drewsum/UV_Blaster/(threads)

Thread 1 (2020-04-20):

LED Selection

drewsum, 2020-04-20:
This looks promising:
https://www.digikey.com/product-detail/en/bivar-inc/SM0603UV-395/492-1949-1-ND/5030564

If I create a square grid, maybe I could do like 25 LEDs per panel...

The idea would be that you could chain multiple panels together with only one master panel controlling a ton of slave panels

drewsum, 2020-04-20:
Consider this for a driver on each card: https://www.analog.com/media/en/technical-documentation/data-sheets/3956f.pdf

Thread 2 (2020-04-20):

LED Driver

drewsum, 2020-04-20:
Consider this from TI, this looks pretty sweet

http://www.ti.com/lit/ds/symlink/lp8556.pdf

drewsum, 2020-04-20:
Actually use this, it's more simple:

http://www.ti.com/lit/ds/symlink/lp8545.pdf
