drewsum/UV_Blaster/hdw/UV_Blaster/UV_Blaster.pdf

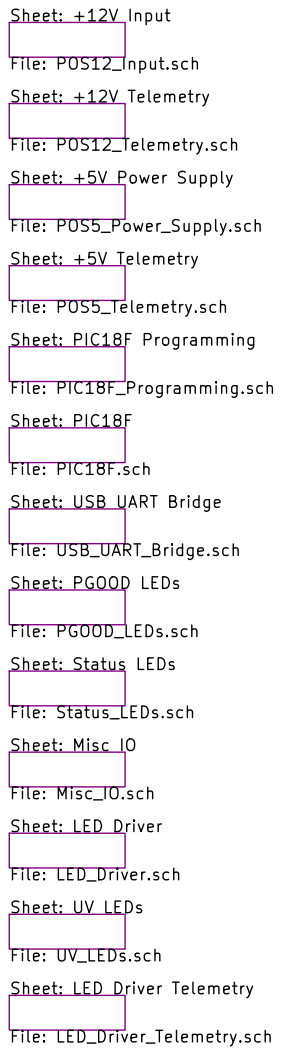
[picture p1: page 1]

File: PIC18F.sch Sheet: USB UART Bridge

File: USB_UART_Bridge.sch Sheet: PGOOD LEDs File: PGOOD_LEDs.sch Sheet: Status LEDs File: Status_LEDs.sch Sheet: Misc IO

File: Misc_IO.sch Sheet: LED Driver File: LED_Driver.sch Sheet: UV LEDs File: UV_LEDs.sch Sheet: LED Driver Telemetry

File: UV_Blaster.sch Sheet: / Drew Maatman

Id: 1/14 Title: UV Blaster

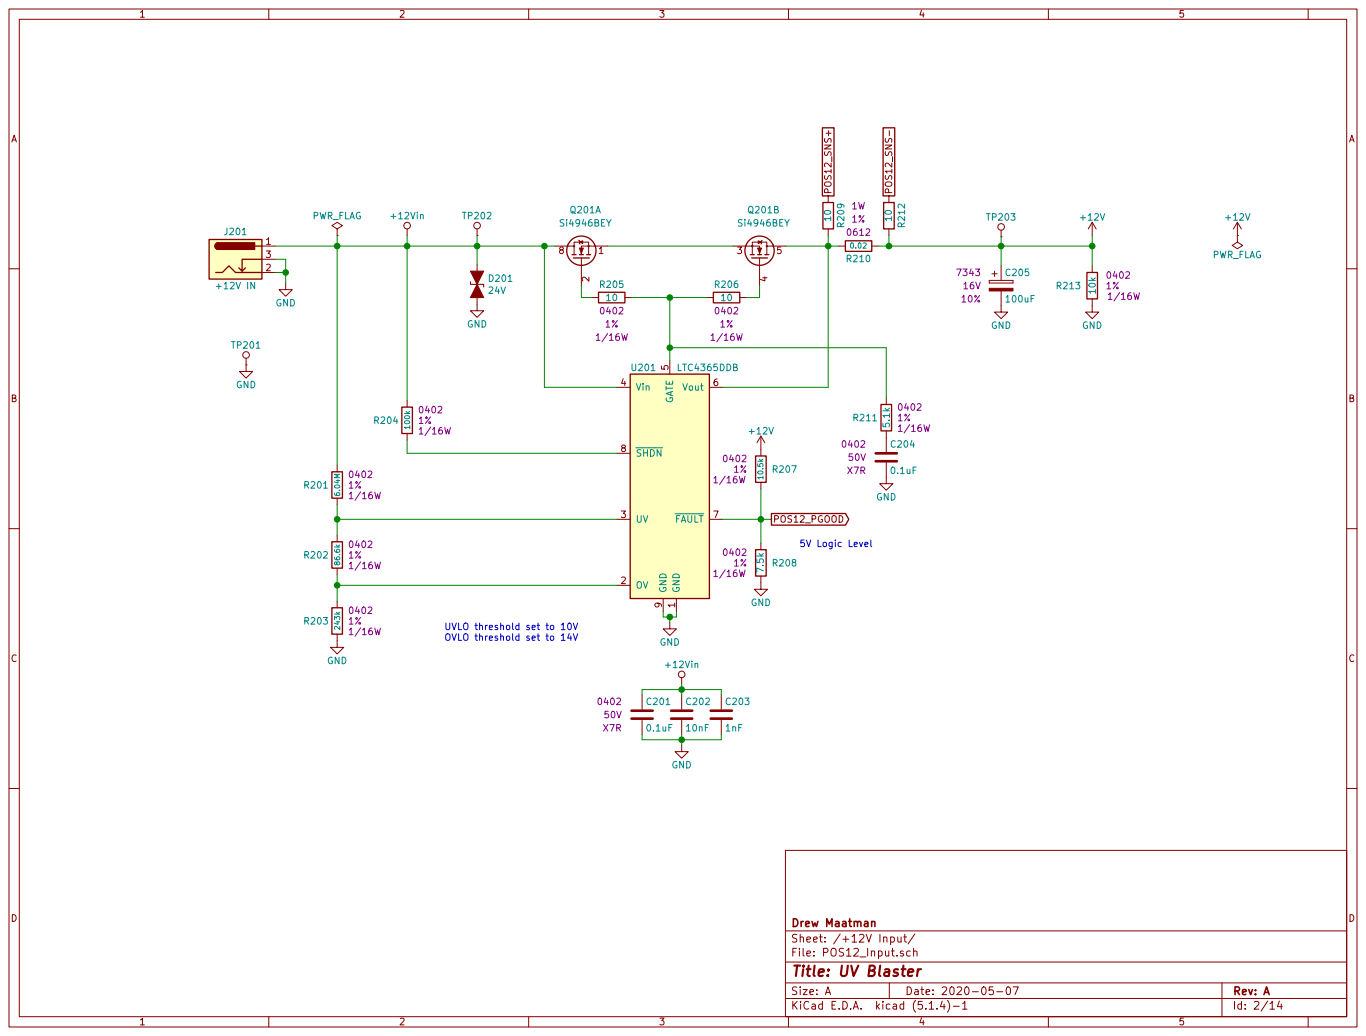
[picture p2: page 2]

5 Vout 6 FAULT 7 SHDN 8 GND

1 OV 2 UV 3 Vin 4 GATE

Sheet: /+12V Input/ Drew Maatman GND GND

File: POS12_Input.sch
Id: 2/14 Title: UV Blaster

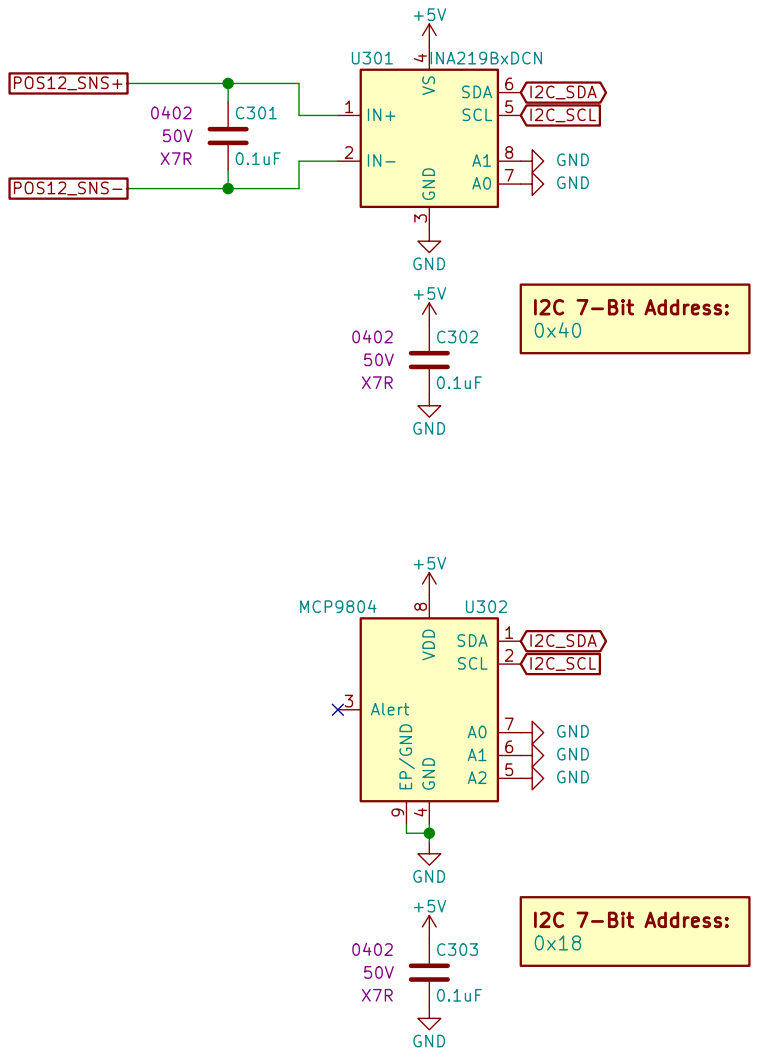
[picture p3: page 3]

Sheet: /+12V Telemetry/ Drew Maatman GND

File: POS12_Telemetry.sch
Id: 3/14 Title: UV Blaster

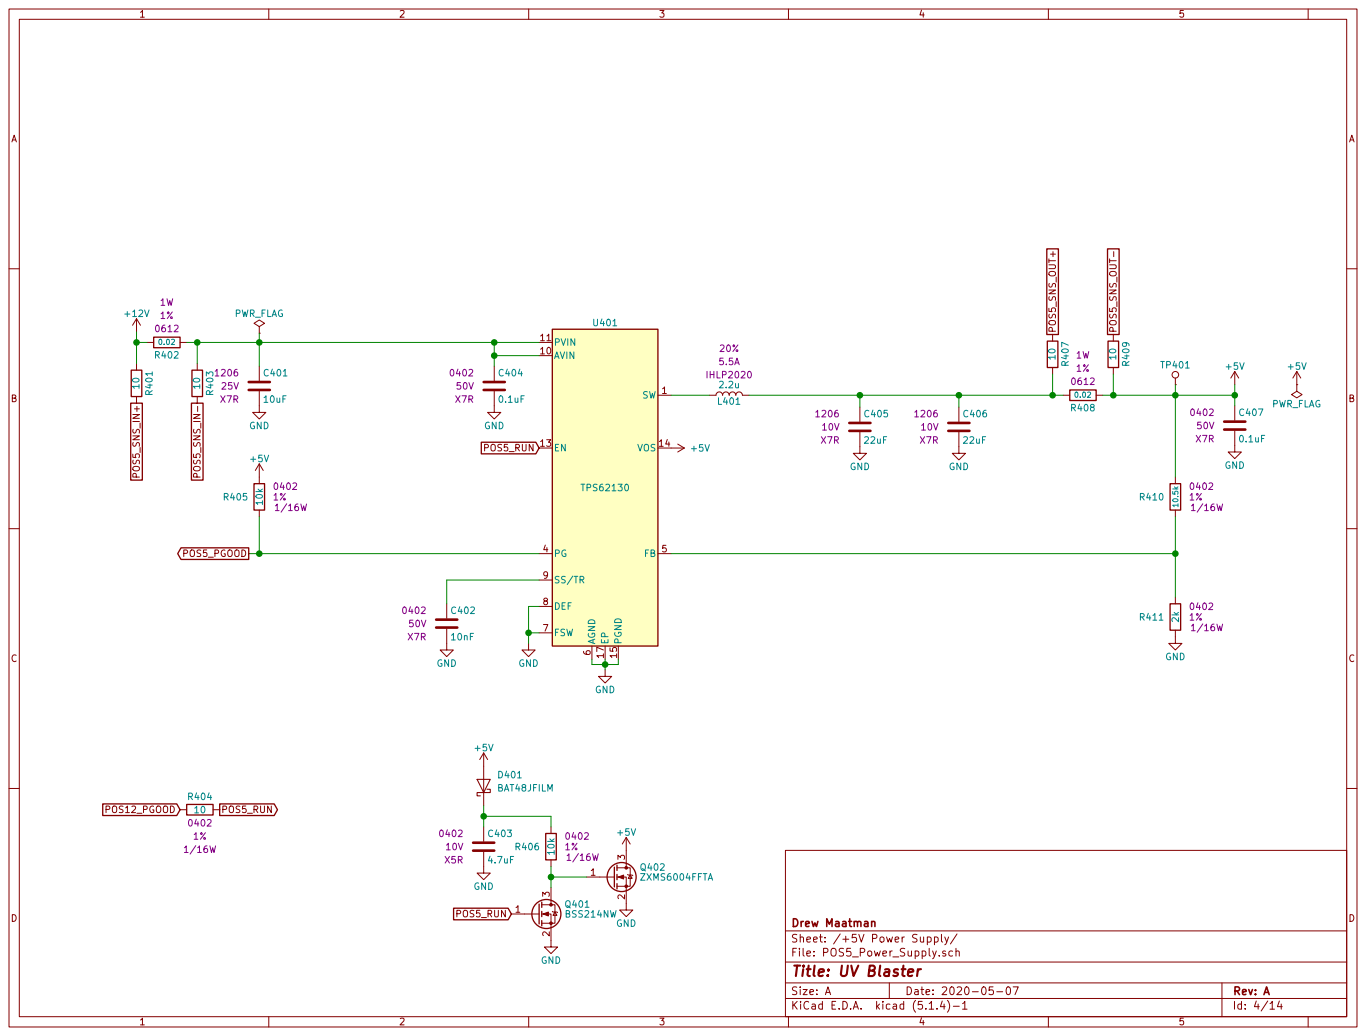
[picture p4: page 4]

6 FSW 7 DEF 8 SS/TR 9 U401 TPS62130 GND

File: POS5_Power_Supply.sch
Id: 4/14 Title: UV Blaster

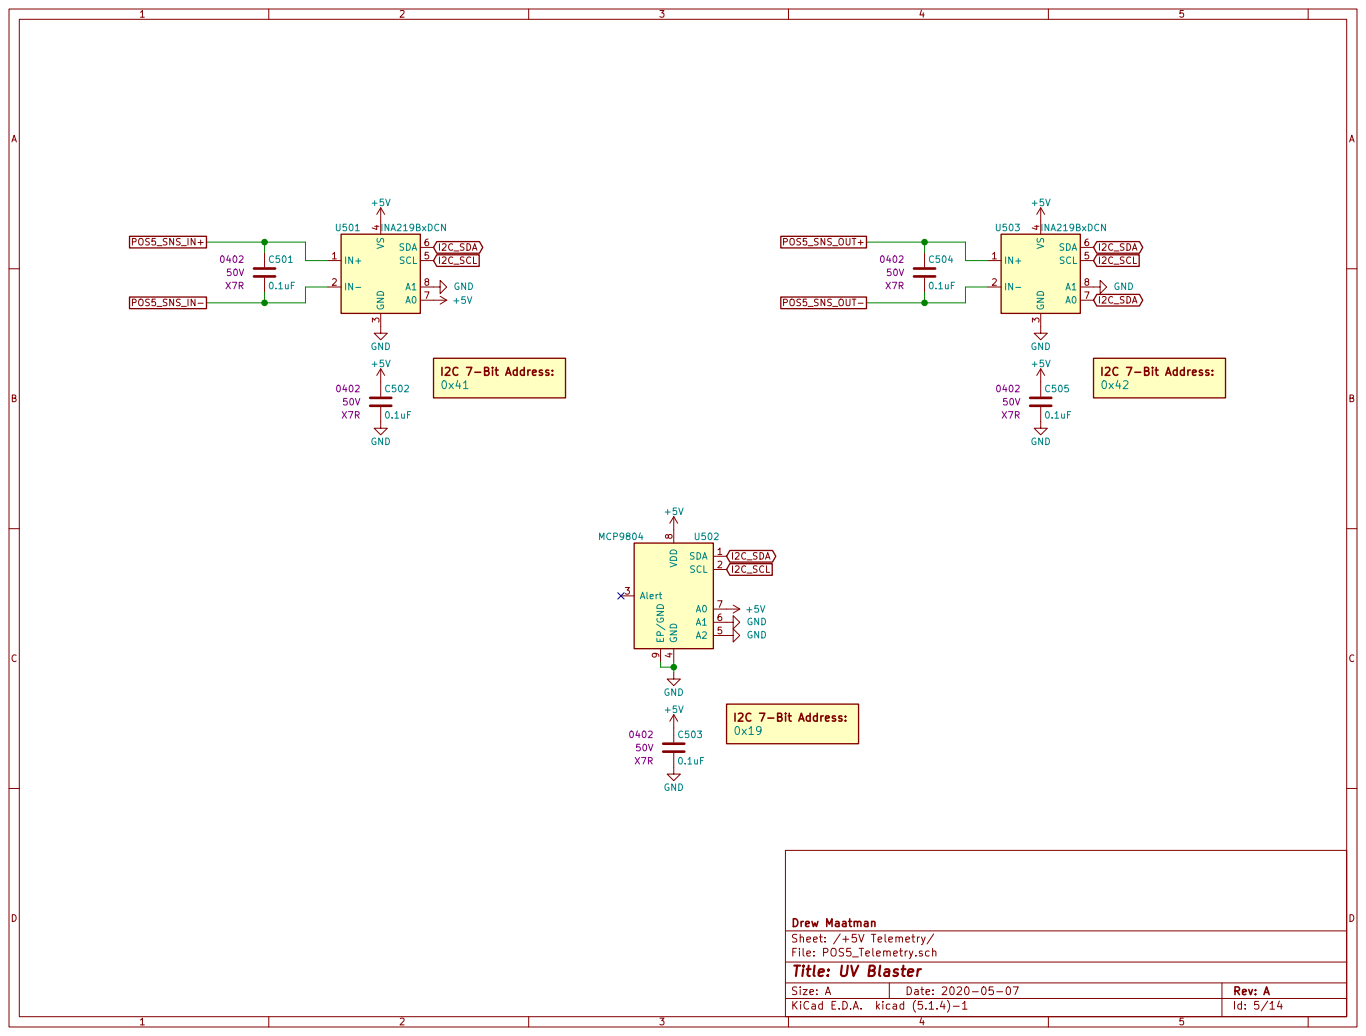
[picture p5: page 5]

Sheet: /+5V Telemetry/ Drew Maatman

File: POS5_Telemetry.sch
Id: 5/14 Title: UV Blaster

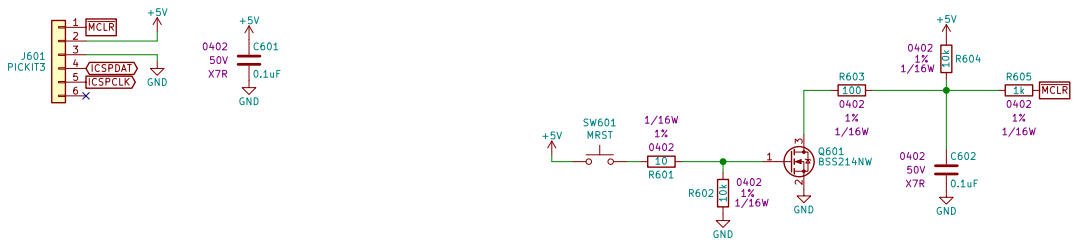
[picture p6: page 6]

Sheet: /PIC18F Programming/ Drew Maatman

File: PIC18F_Programming.sch
Id: 6/14 Title: UV Blaster

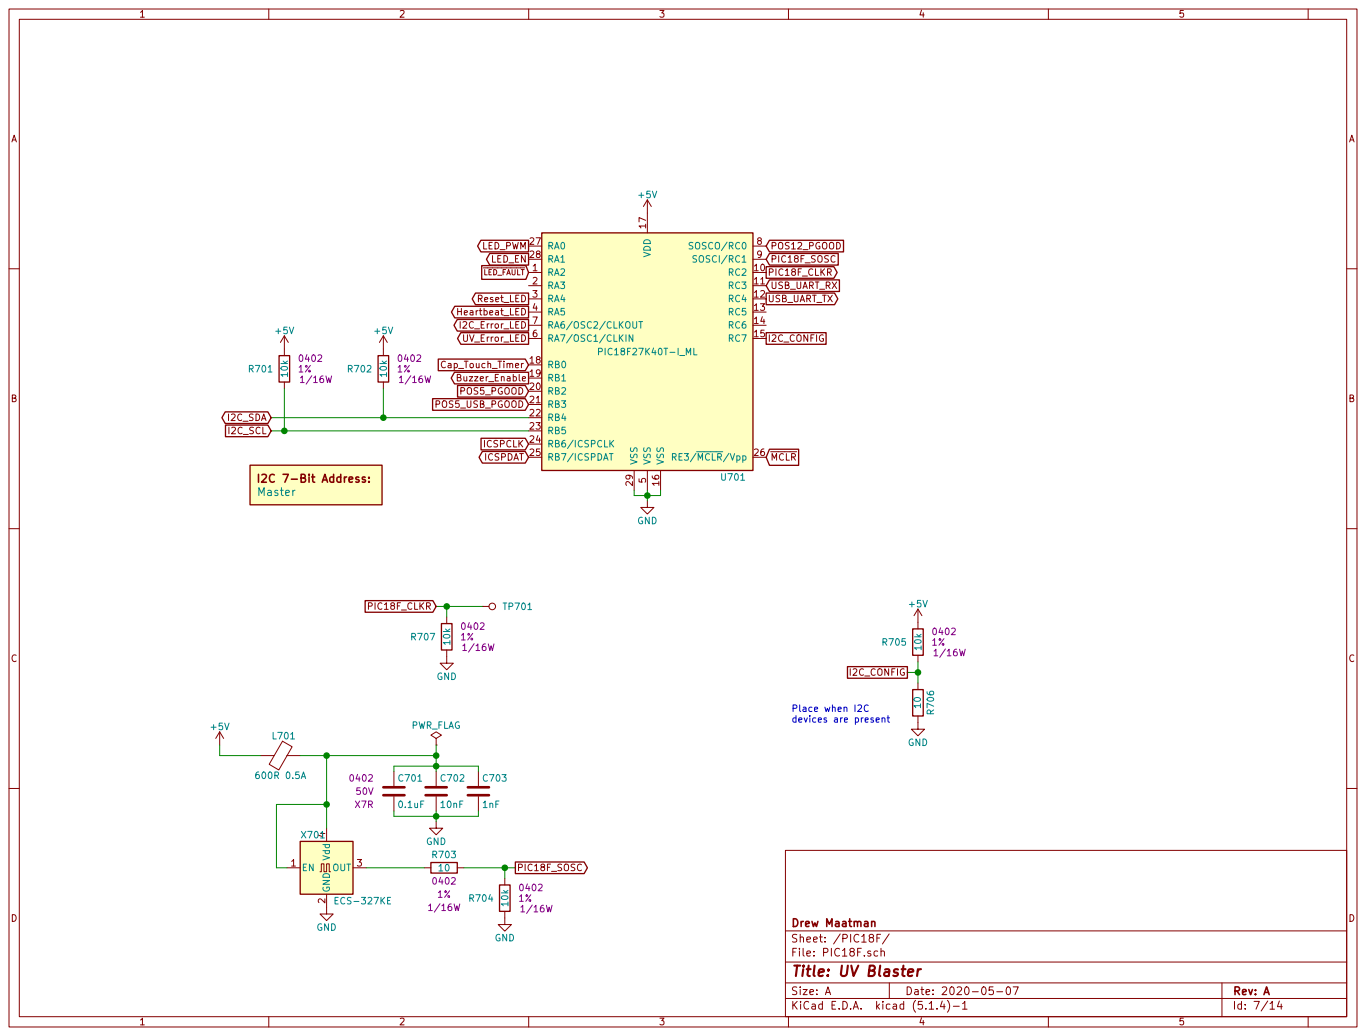
[picture p7: page 7]

2 OUT 3 Vdd X701 4 ECS-327KE GND

Id: 7/14 Title: UV Blaster File: PIC18F.sch Sheet: /PIC18F/ Drew Maatman

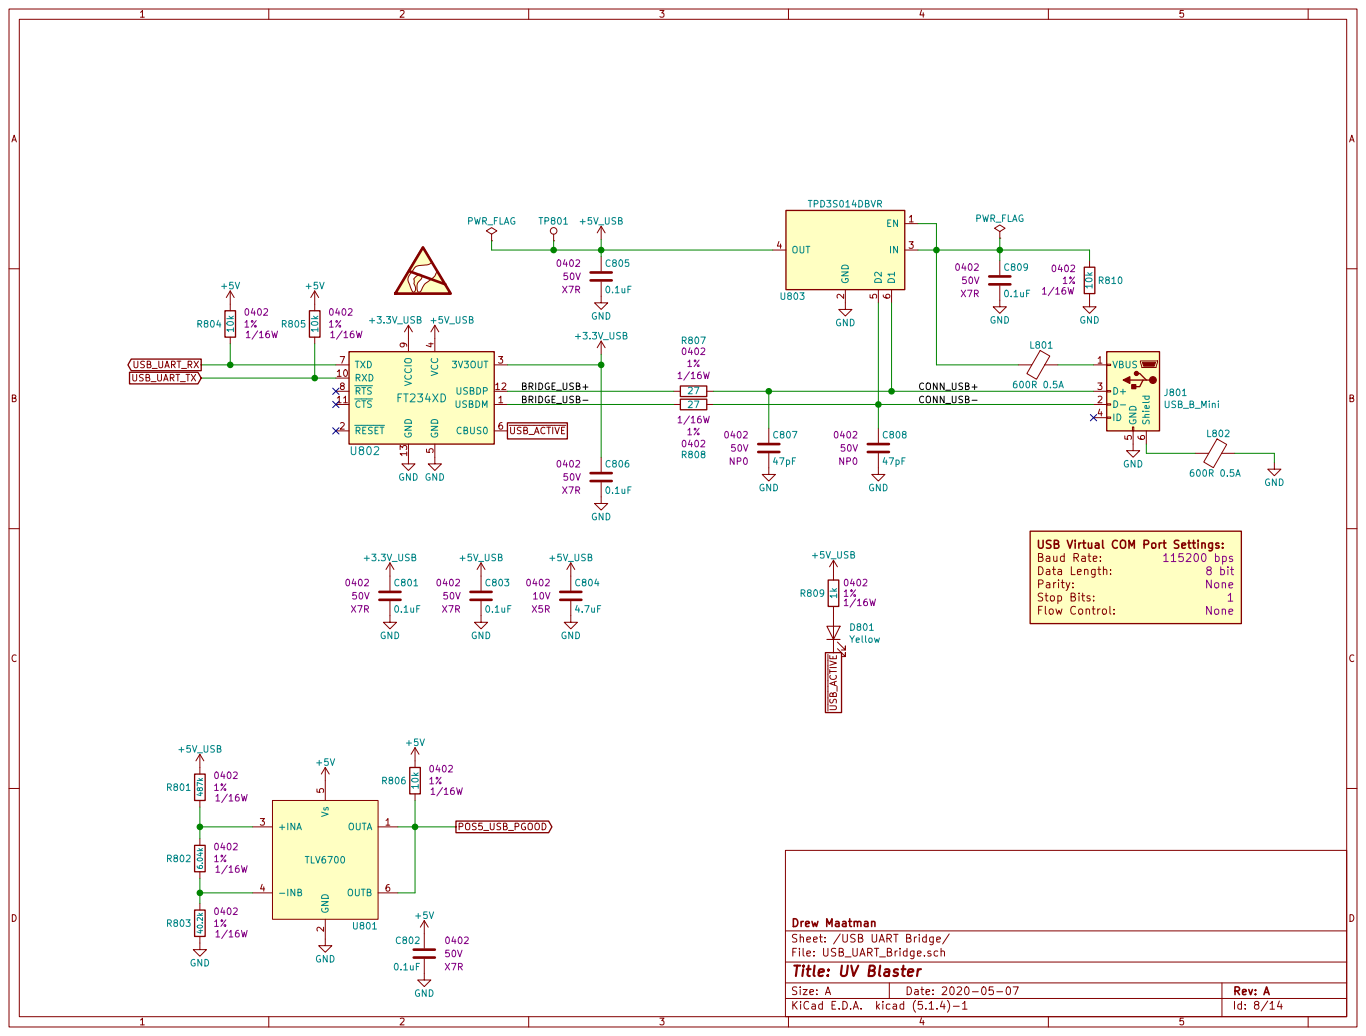
[picture p8: page 8]

USB Virtual COM Port Settings:
Baud Rate: Data Length:

File: USB_UART_Bridge.sch
Id: 8/14 Title: UV Blaster

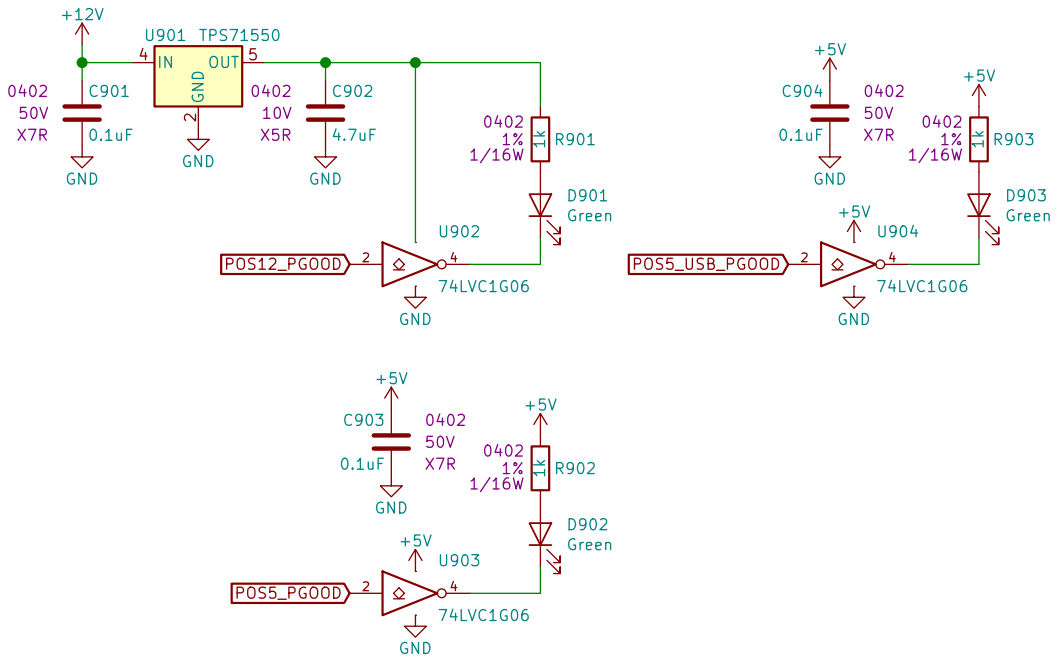
[picture p9: page 9]

File: PGOOD_LEDs.sch Sheet: /PGOOD LEDs/ Drew Maatman

Id: 9/14 Title: UV Blaster

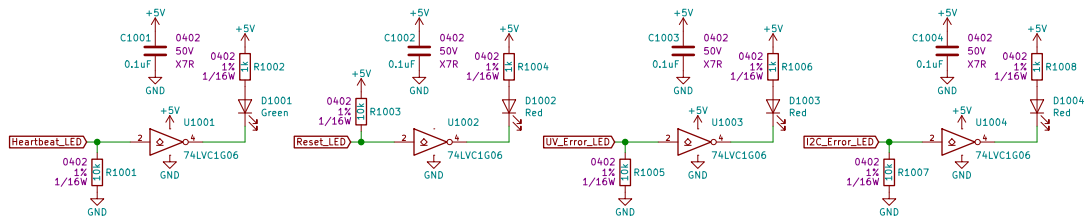
[picture p10: page 10]

File: Status_LEDs.sch Sheet: /Status LEDs/ Drew Maatman

Id: 10/14 Title: UV Blaster

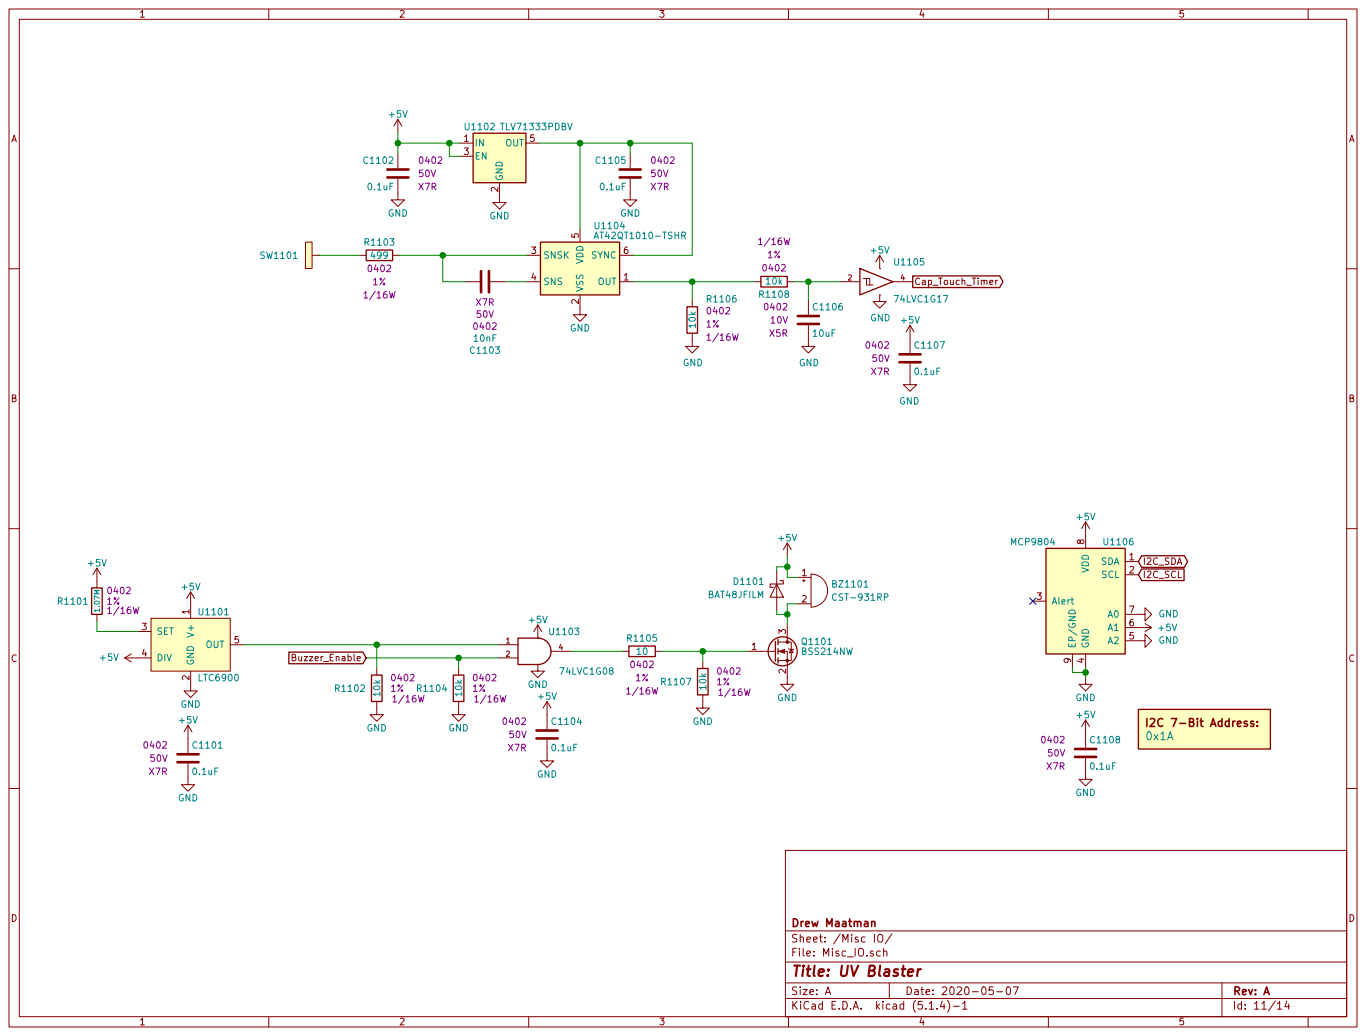
[picture p11: page 11]

1 GND
File: Misc_IO.sch Sheet: /Misc IO/ Drew Maatman V+

Id: 11/14 Title: UV Blaster

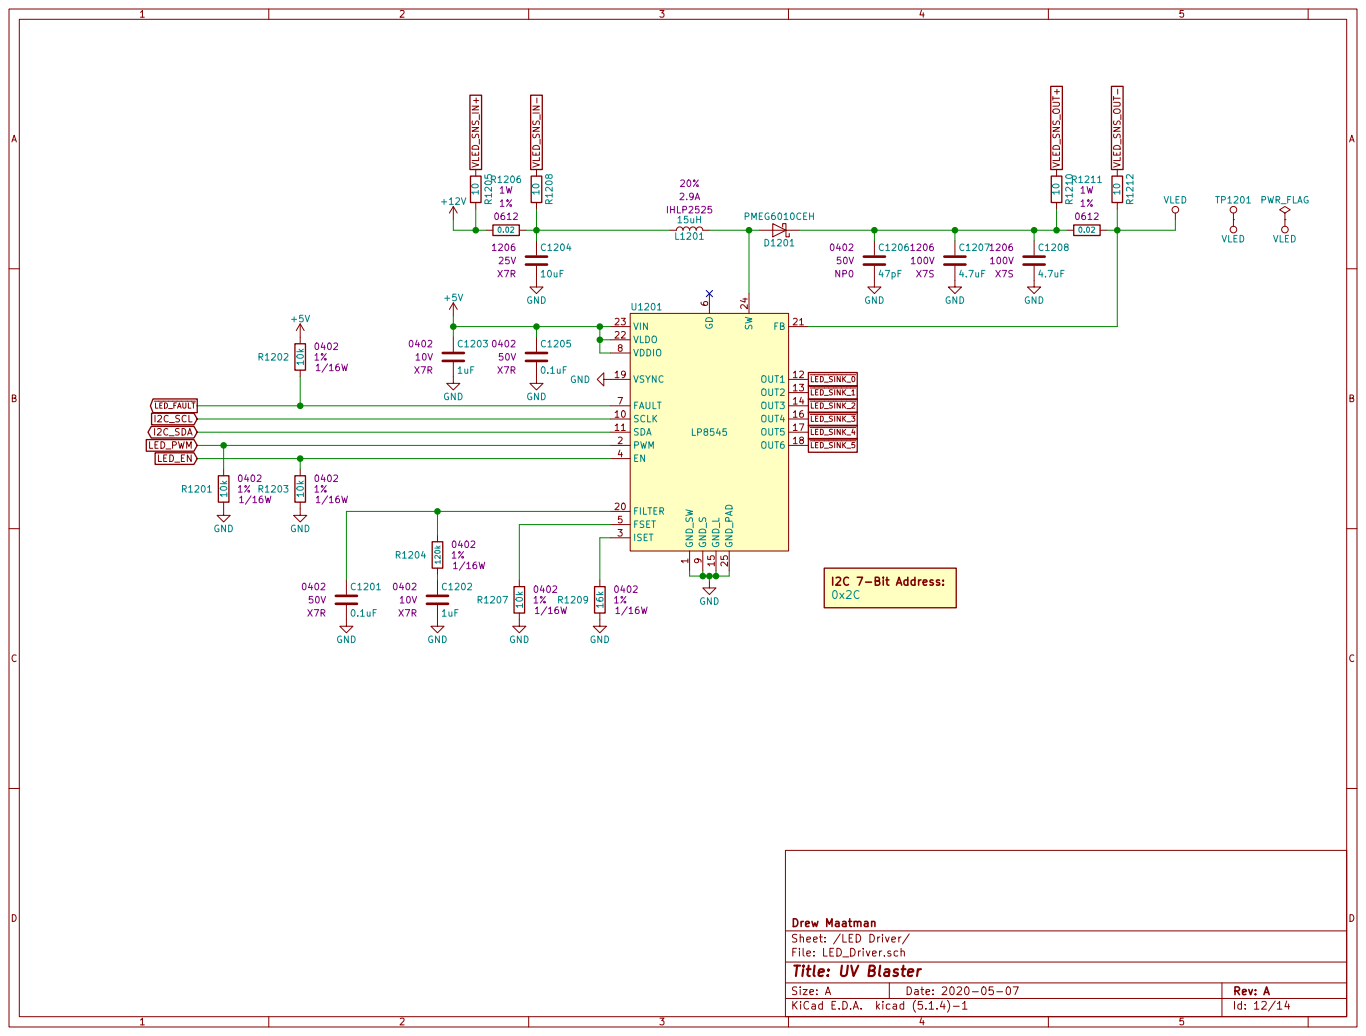
[picture p12: page 12]

1 SCLK 10 SDA 11 OUT1 12 OUT2 13 OUT3 14 GND_L 15 OUT4 16 OUT5 17 OUT6 18 VSYNC 19 PWM 2 FILTER 20 FB 21 VLDO 22 VIN 23 SW 24 GND_PAD 25

File: LED_Driver.sch Sheet: /LED Driver/ Drew Maatman

Id: 12/14 Title: UV Blaster

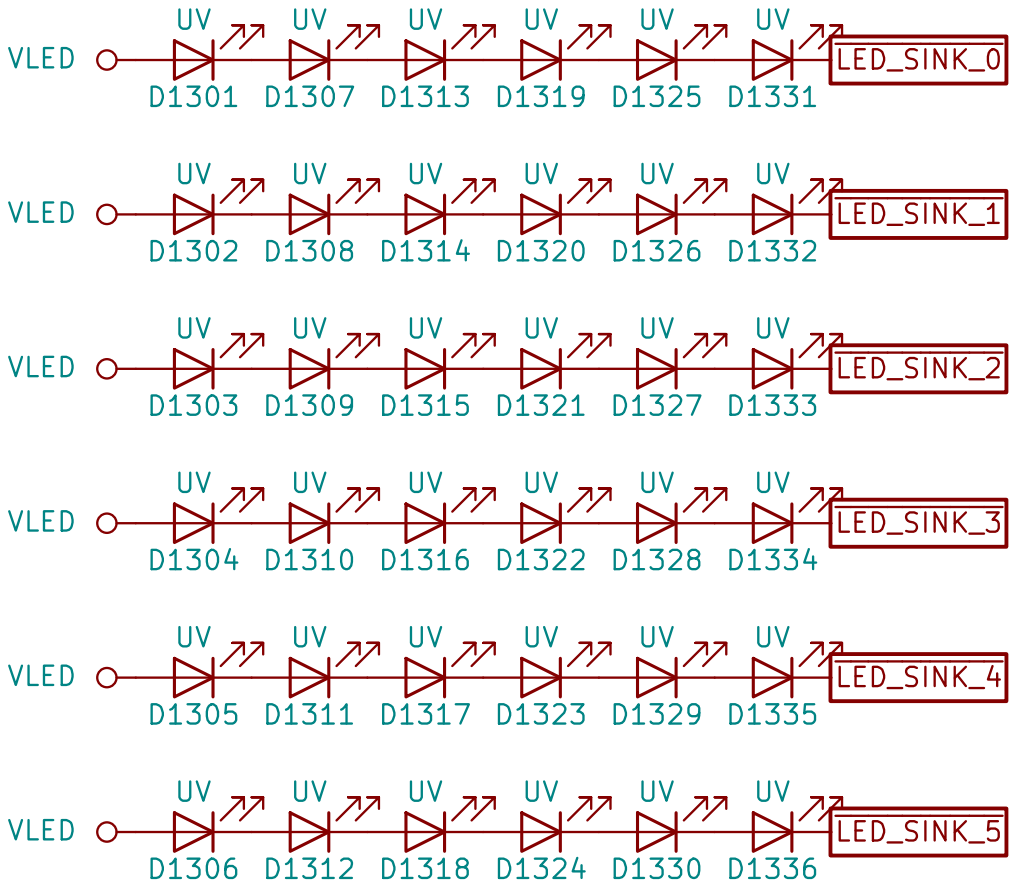
[picture p13: page 13]

File: UV_LEDs.sch Sheet: /UV LEDs/ Drew Maatman D1317 UV D1304 UV

Id: 13/14 Title: UV Blaster

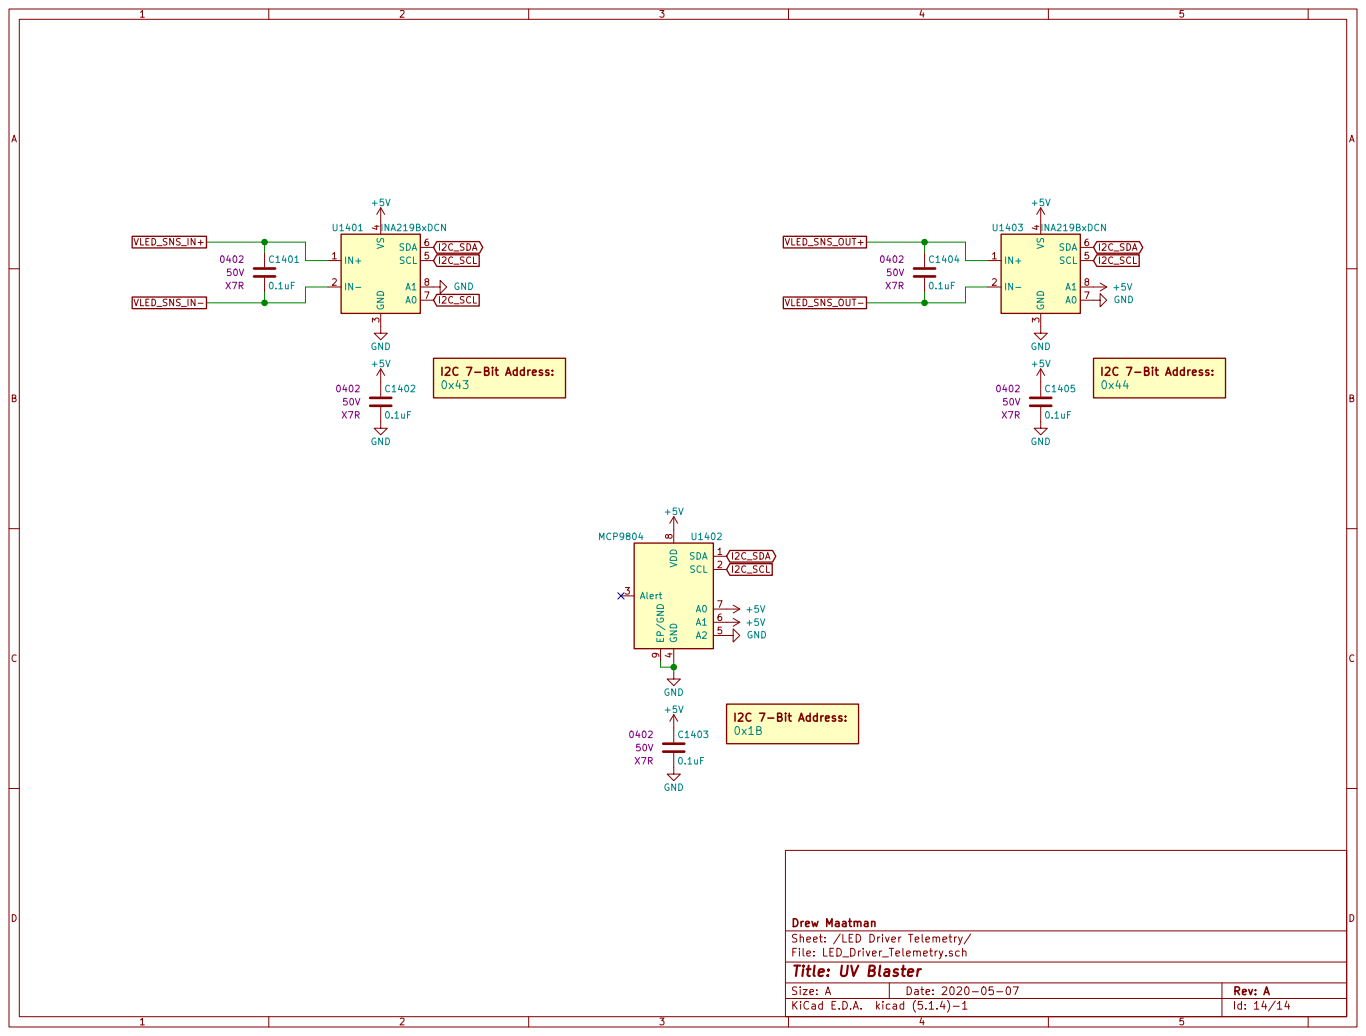
[picture p14: page 14]

Sheet: /LED Driver Telemetry/ Drew Maatman

File: LED_Driver_Telemetry.sch
Id: 14/14 Title: UV Blaster
