drewsum/UV_Blaster/hdw/UV_Blaster/UV_Blaster.kicad_pcb

## KiCad design hdw/UV_Blaster/UV_Blaster.kicad_pcb (2020-05-08)

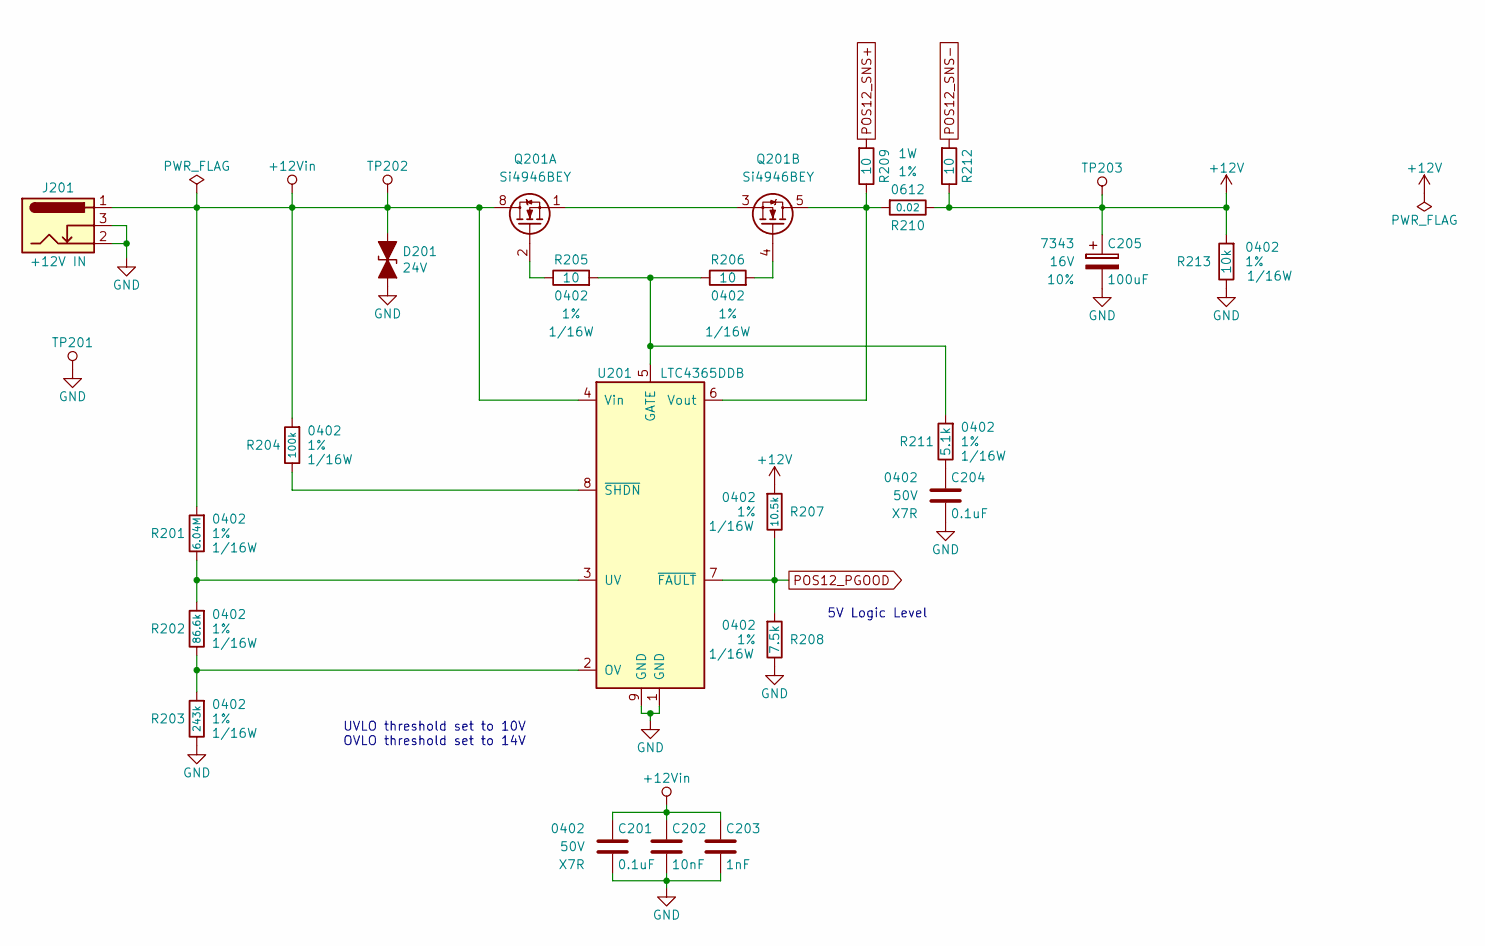
[picture p15: schematic POS12_Input.sch, UV Blaster]

Parts:
C201, C204: 0.1uF; C_0402; Voltage 50V; Digi-Key PN 490-10701-1-ND
C202: 10nF; C_0402; Voltage 50V; Digi-Key PN 490-13295-1-ND
C203: 1nF; C_0402; Voltage 50V; Digi-Key PN 399-1032-1-ND
C205: 100uF; CP_Tantalum_Case-X_EIA-7343-43_Reflow; Voltage 16V; Tolerance 10%; Digi-Key PN 718-1102-1-ND
D201: 24V; D_SMA; Digi-Key PN SMAJ24CALFCT-ND
J201: +12V IN; BARREL_JACK
Q201: Si4946BEY; SOIC-8_3.9x4.9mm_P1.27mm; Digi-Key PN SI4946BEY-T1-E3CT-ND
R201: 6.04M; R_0402; Tolerance 1%; Digi-Key PN 541-CRCW04026M04FKEDCT-ND
R202: 86.6k; R_0402; Tolerance 1%; Digi-Key PN P86.6KLCT-ND
R203: 243k; R_0402; Tolerance 1%; Digi-Key PN YAG3070CT-ND
R204: 100k; R_0402; Tolerance 1%; Digi-Key PN 311-100KLRCT-ND
R205, R206, R209, R212: 10; R_0402; Tolerance 1%; Digi-Key PN 311-10.0LRCT-ND
R207: 10.5k; R_0402; Tolerance 1%; Digi-Key PN RMCF0402FT10K5CT-ND
R208: 7.5k; R_0402; Tolerance 1%; Digi-Key PN RMCF0402FT7K50CT-ND
R210: 0.02; R_0612; Tolerance 1%; Digi-Key PN P16010CT-ND
R211: 5.1k; R_0402; Tolerance 1%; Digi-Key PN P5.10KLCT-ND
R213: 10k; R_0402; Tolerance 1%; Digi-Key PN 541-3959-1-ND
TP201: TP; Pin_Header_Angled_1x01_Pitch2.54mm
TP202, TP203: TP; Test_Point
U201: LTC4365DDB; DFN-8-1EP_2x3mm_Pitch0.5mm; Digi-Key PN LTC4365IDDB#TRMPBFCT-ND

Connections:
+12V: C205.1, R207.1, R210.2, R212.2, R213.1, TP203.1; also elsewhere on the board
+12Vin: C201.1, C202.1, C203.1, D201.1 (A1), J201.1, Q201.7 (D1), Q201.8 (D1), R201.1, R204.1, TP202.1, U201.4 (Vin)
GND: C201.2, C202.2, C203.2, C204.2, C205.2, D201.2 (A2), J201.2, J201.3, R203.2, R208.2, R213.2, TP201.1, U201.1 (GND), U201.9 (GND); also elsewhere on the board
unnamed: C204.1, R211.2
unnamed: Q201.1 (S1), Q201.3 (S2)
unnamed: Q201.2 (G1), R205.2
unnamed: Q201.4 (G2), R206.1
unnamed: Q201.5 (D2), Q201.6 (D2), R209.2, R210.1, U201.6 (Vout)
unnamed: R201.2, R202.1, U201.3 (UV)
unnamed: R202.2, R203.1, U201.2 (OV)
unnamed: R204.2, U201.8 (~SHDN)
unnamed: R205.1, R206.2, R211.1, U201.5 (GATE)
POS12_PGOOD: R207.2, R208.1, U201.7 (~FAULT); also elsewhere on the board
POS12_SNS+: R209.1; also elsewhere on the board
POS12_SNS-: R212.1; also elsewhere on the board

Notes on the sheet:
UVLO threshold set to 10V OVLO threshold set to 14V
5V Logic Level

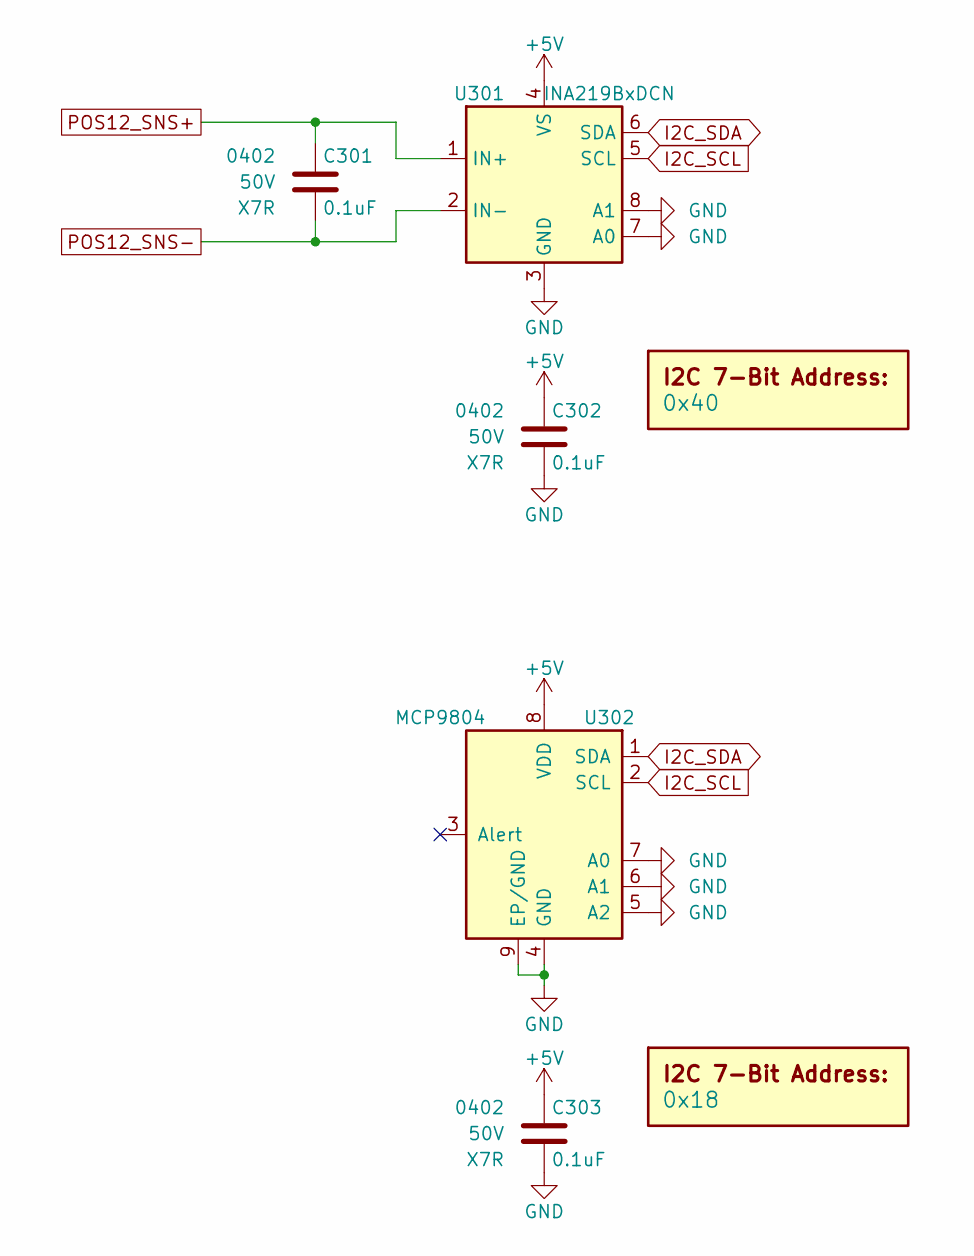
[picture p16: schematic POS12_Telemetry.sch, UV Blaster]

Parts:
C301, C302, C303: 0.1uF; C_0402; Voltage 50V; Digi-Key PN 490-10701-1-ND
DOC301: 0x40
DOC302: 0x18
U301: INA219BxDCN; SOT-23-8; Digi-Key PN 296-46420-1-ND
U302: MCP9804; DFN-8-1EP_3x2mm_P0.5mm_EP1.3x1.5mm; Digi-Key PN MCP9804T-E/MCCT-ND

Connections:
+5V: C302.1, C303.1, U301.4 (VS), U302.8 (VDD); also elsewhere on the board
GND: C302.2, C303.2, U301.3 (GND), U301.7 (A0), U301.8 (A1), U302.4 (GND), U302.5 (A2), U302.6 (A1), U302.7 (A0), U302.9 (EP/GND); also elsewhere on the board
I2C_SCL: U301.5 (SCL), U302.2 (SCL); also elsewhere on the board
I2C_SDA: U301.6 (SDA), U302.1 (SDA); also elsewhere on the board
POS12_SNS+: C301.1, U301.1 (IN+); also elsewhere on the board
POS12_SNS-: C301.2, U301.2 (IN-); also elsewhere on the board

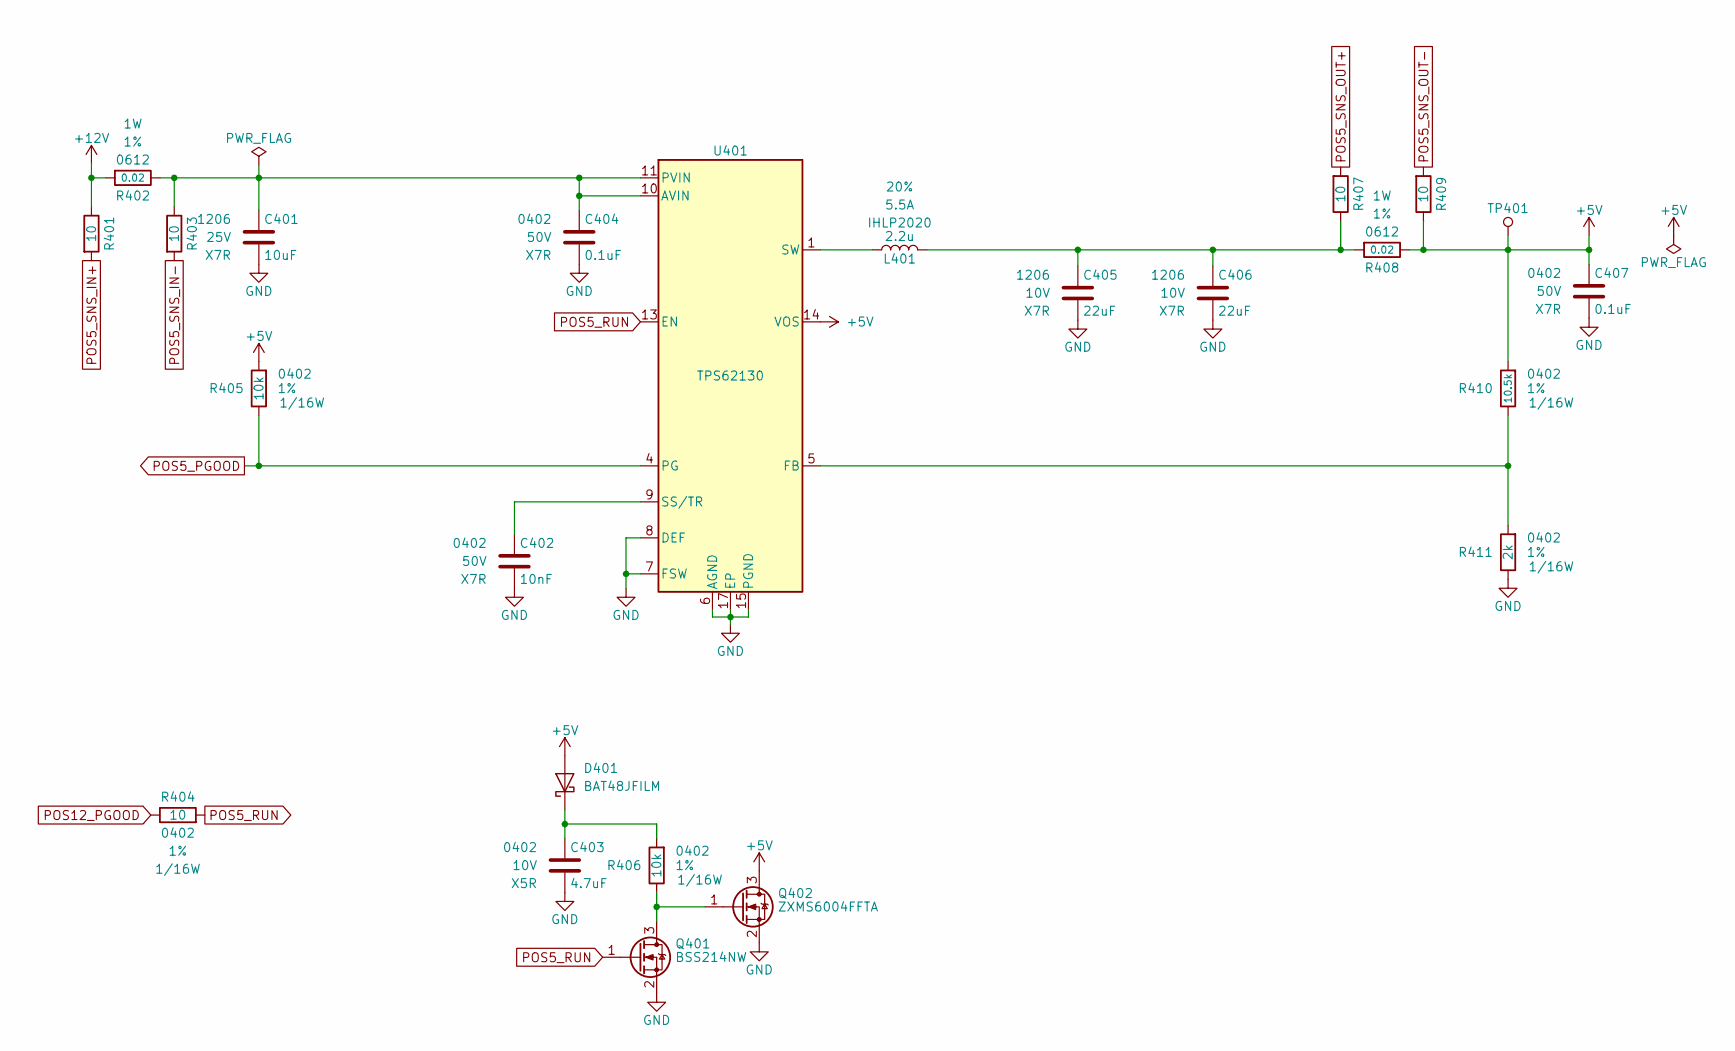
[picture p17: schematic POS5_Power_Supply.sch, UV Blaster]

Parts:
C401: 10uF; C_1206; Voltage 25V; Digi-Key PN 1276-7031-1-ND
C402: 10nF; C_0402; Voltage 50V; Digi-Key PN 490-13295-1-ND
C403: 4.7uF; C_0402; Voltage 10V; Digi-Key PN 490-14306-1-ND
C404, C407: 0.1uF; C_0402; Voltage 50V; Digi-Key PN 490-10701-1-ND
C405, C406: 22uF; C_1206; Voltage 10V; Digi-Key PN 1276-3148-1-ND
D401: BAT48JFILM; D_SOD-323; Digi-Key PN 497-5711-1-ND
L401: 2.2u; L_Vishay_IHLP-2020; Tolerance 20%; Digi-Key PN 541-1236-1-ND
Q401: BSS214NW; SOT-323_SC-70; Digi-Key PN BSS214NWH6327XTSA1CT-ND
Q402: ZXMS6004FFTA; SOT-23; Digi-Key PN ZXMS6004FFCT-ND
R401, R403, R404, R407, R409: 10; R_0402; Tolerance 1%; Digi-Key PN 311-10.0LRCT-ND
R402, R408: 0.02; R_0612; Tolerance 1%; Digi-Key PN P16010CT-ND
R405, R406: 10k; R_0402; Tolerance 1%; Digi-Key PN 541-3959-1-ND
R410: 10.5k; R_0402; Tolerance 1%; Digi-Key PN RMCF0402FT10K5CT-ND
R411: 2k; R_0402; Tolerance 1%; Digi-Key PN 311-2KLRCT-ND
TP401: TP; Test_Point
U401: TPS62130; QFN-16-1EP_3x3mm_Pitch0.5mm; Digi-Key PN 296-37878-1-ND

Connections:
+5V: C407.1, D401.2 (A), Q402.3 (D), R405.1, R408.2, R409.2, R410.1, TP401.1, U401.14 (VOS); also elsewhere on the board
+12V: R401.2, R402.1; also elsewhere on the board
GND: C401.2, C402.2, C403.2, C404.2, C405.2, C406.2, C407.2, Q401.2 (S), Q402.2 (S), R411.2, U401.6 (AGND), U401.7 (FSW), U401.8 (DEF), U401.15 (PGND), U401.16 (PGND), U401.17 (EP); also elsewhere on the board
unnamed: C401.1, C404.1, R402.2, R403.2, U401.10 (AVIN), U401.11 (PVIN), U401.12 (PVIN)
unnamed: C402.1, U401.9 (SS/TR)
unnamed: C403.1, D401.1 (K), R406.1
unnamed: C405.1, C406.1, L401.2, R407.2, R408.1
unnamed: L401.1, U401.1 (SW), U401.2 (SW), U401.3 (SW)
unnamed: Q401.3 (D), Q402.1 (G), R406.2
unnamed: R410.2, R411.1, U401.5 (FB)
POS5_PGOOD: R405.2, U401.4 (PG); also elsewhere on the board
POS5_RUN: Q401.1 (G), R404.1, U401.13 (EN)
POS5_SNS_IN+: R401.1; also elsewhere on the board
POS5_SNS_IN-: R403.1; also elsewhere on the board
POS5_SNS_OUT+: R407.1; also elsewhere on the board
POS5_SNS_OUT-: R409.1; also elsewhere on the board
POS12_PGOOD: R404.2; also elsewhere on the board

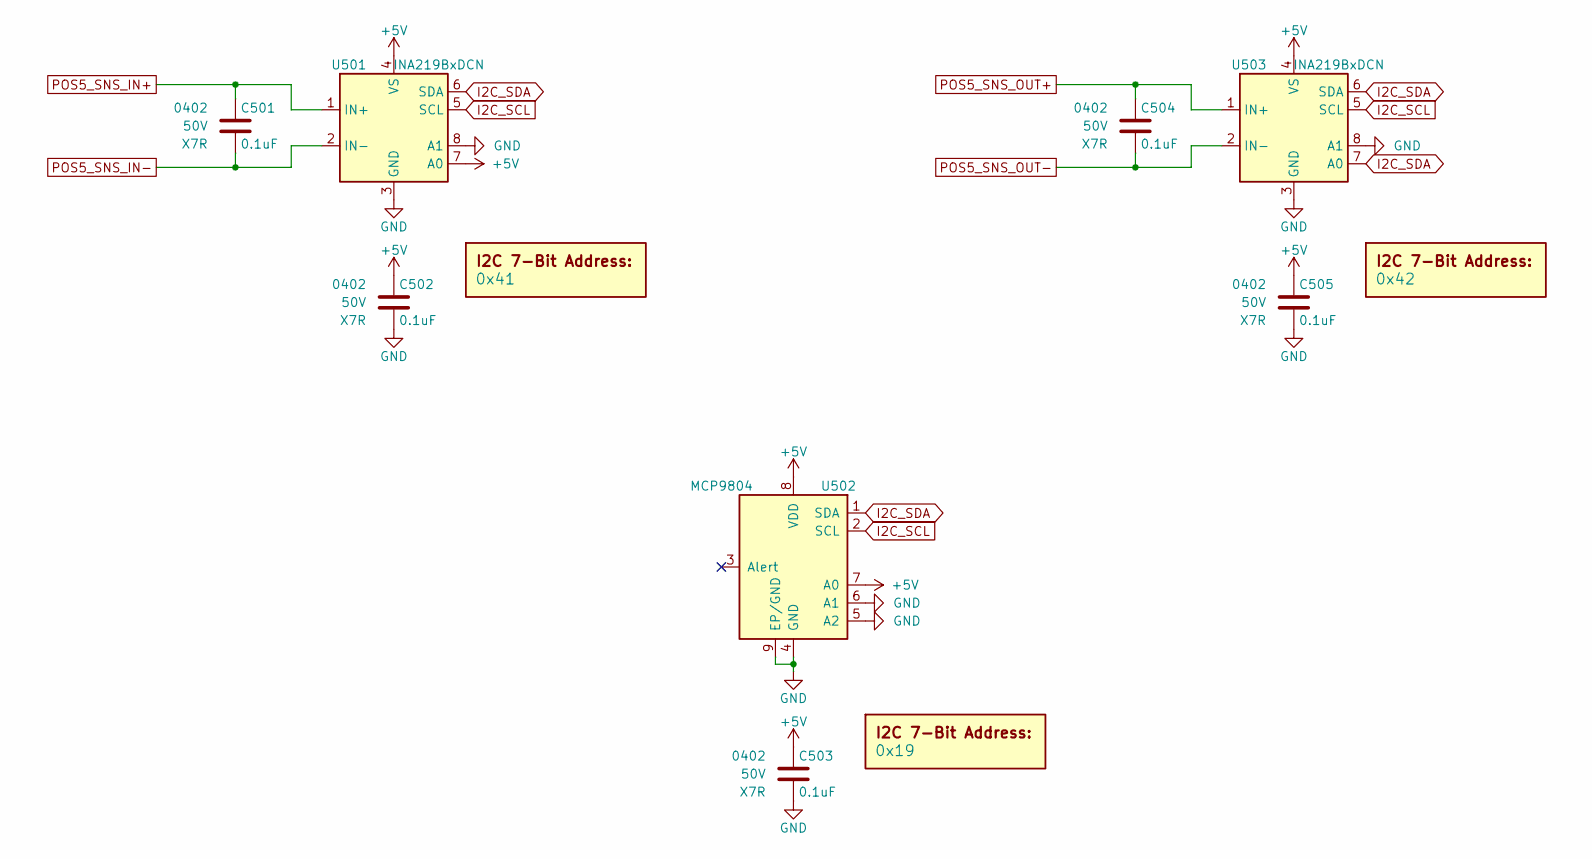
[picture p18: schematic POS5_Telemetry.sch, UV Blaster]

Parts:
C501, C502, C503, C504, C505: 0.1uF; C_0402; Voltage 50V; Digi-Key PN 490-10701-1-ND
DOC501: 0x41
DOC502: 0x19
DOC503: 0x42
U501, U503: INA219BxDCN; SOT-23-8; Digi-Key PN 296-46420-1-ND
U502: MCP9804; DFN-8-1EP_3x2mm_P0.5mm_EP1.3x1.5mm; Digi-Key PN MCP9804T-E/MCCT-ND

Connections:
+5V: C502.1, C503.1, C505.1, U501.4 (VS), U501.7 (A0), U502.7 (A0), U502.8 (VDD), U503.4 (VS); also elsewhere on the board
GND: C502.2, C503.2, C505.2, U501.3 (GND), U501.8 (A1), U502.4 (GND), U502.5 (A2), U502.6 (A1), U502.9 (EP/GND), U503.3 (GND), U503.8 (A1); also elsewhere on the board
I2C_SCL: U501.5 (SCL), U502.2 (SCL), U503.5 (SCL); also elsewhere on the board
I2C_SDA: U501.6 (SDA), U502.1 (SDA), U503.6 (SDA), U503.7 (A0); also elsewhere on the board
POS5_SNS_IN+: C501.1, U501.1 (IN+); also elsewhere on the board
POS5_SNS_IN-: C501.2, U501.2 (IN-); also elsewhere on the board
POS5_SNS_OUT+: C504.1, U503.1 (IN+); also elsewhere on the board
POS5_SNS_OUT-: C504.2, U503.2 (IN-); also elsewhere on the board

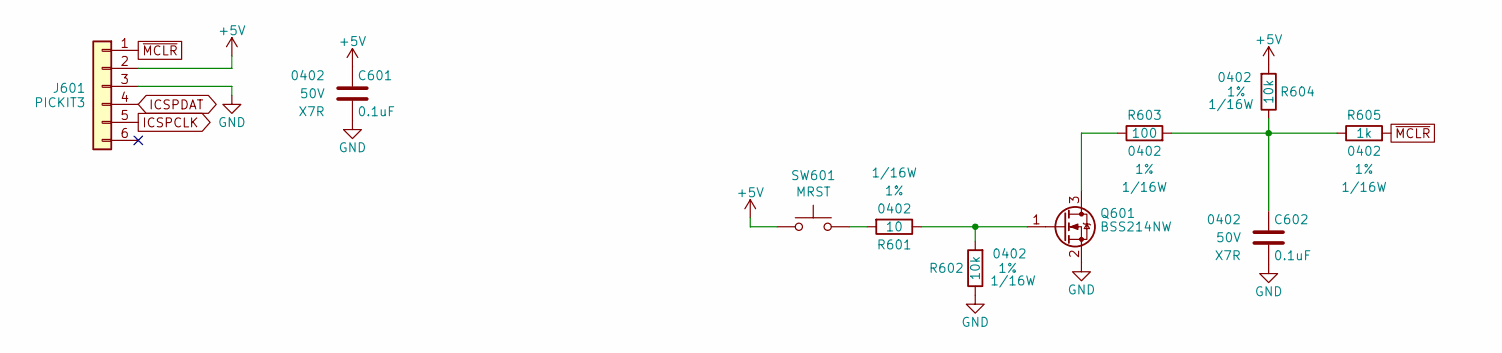
[picture p19: schematic PIC18F_Programming.sch, UV Blaster]

Parts:
C601, C602: 0.1uF; C_0402; Voltage 50V; Digi-Key PN 490-10701-1-ND
J601: PICKIT3; PICKIT3_Header
Q601: BSS214NW; SOT-323_SC-70; Digi-Key PN BSS214NWH6327XTSA1CT-ND
R601: 10; R_0402; Tolerance 1%; Digi-Key PN 311-10.0LRCT-ND
R602, R604: 10k; R_0402; Tolerance 1%; Digi-Key PN 541-3959-1-ND
R603: 100; R_0402; Tolerance 1%; Digi-Key PN 311-100LRCT-ND
R605: 1k; R_0402; Tolerance 1%; Digi-Key PN P1.00KLCT-ND
SW601: MRST; SW_PUSH_6mm

Connections:
+5V: C601.1, J601.2, R604.1, SW601.1; also elsewhere on the board
GND: C601.2, C602.2, J601.3, Q601.2 (S), R602.2; also elsewhere on the board
ICSPCLK: J601.5; also elsewhere on the board
ICSPDAT: J601.4; also elsewhere on the board
unnamed: C602.1, R603.1, R604.2, R605.2
unnamed: Q601.1 (G), R601.2, R602.1
unnamed: Q601.3 (D), R603.2
unnamed: R601.1, SW601.2
~MCLR: J601.1, R605.1; also elsewhere on the board

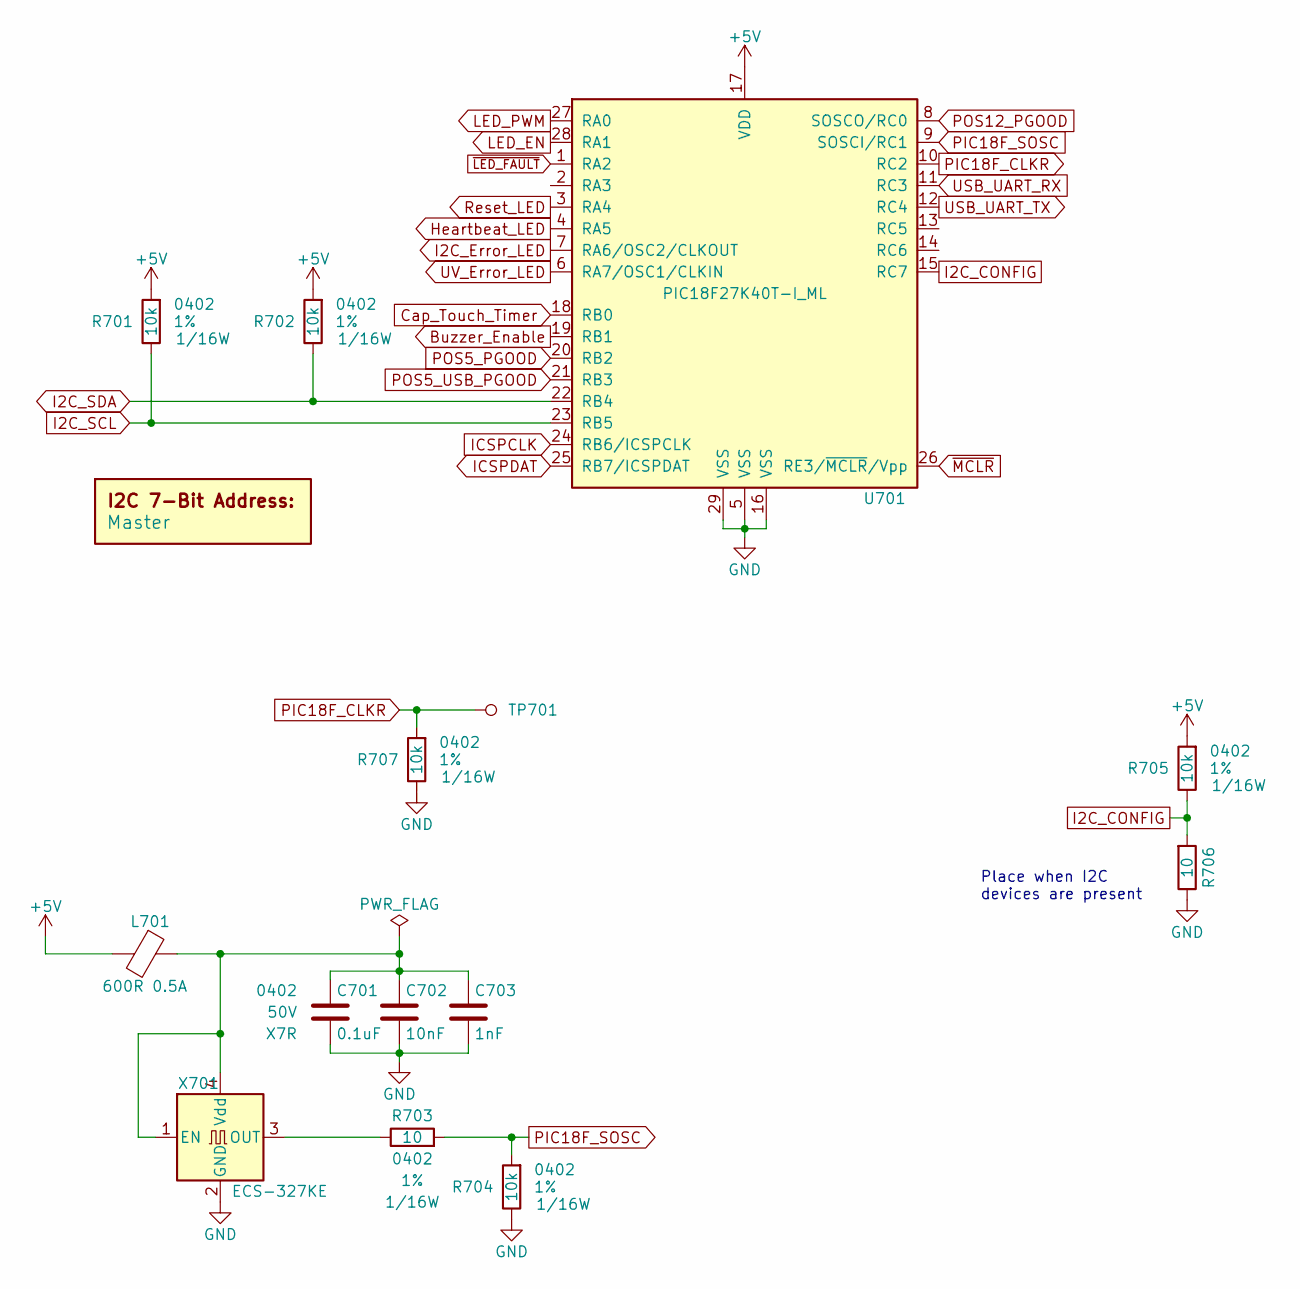
[picture p20: schematic PIC18F.sch, UV Blaster]

Parts:
C701: 0.1uF; C_0402; Voltage 50V; Digi-Key PN 490-10701-1-ND
C702: 10nF; C_0402; Voltage 50V; Digi-Key PN 490-13295-1-ND
C703: 1nF; C_0402; Voltage 50V; Digi-Key PN 399-1032-1-ND
DOC701: Master
L701: 600R 0.5A; L_0402; Digi-Key PN 490-16584-1-ND
R701, R702, R704, R705, R707: 10k; R_0402; Tolerance 1%; Digi-Key PN 541-3959-1-ND
R703, R706: 10; R_0402; Tolerance 1%; Digi-Key PN 311-10.0LRCT-ND
TP701: TP; Test_Point
U701: PIC18F27K40T-I_ML; QFN-28-1EP_6x6mm_Pitch0.65mm; Digi-Key PN PIC18F27K40T-I/MLCT-ND
X701: ECS-327KE; Digi-Key PN XC1751CT-ND

Connections:
+5V: L701.2, R701.1, R702.1, R705.1, U701.17 (VDD); also elsewhere on the board
Buzzer_Enable: U701.19 (RB1); also elsewhere on the board
Cap_Touch_Timer: U701.18 (RB0); also elsewhere on the board
GND: C701.2, C702.2, C703.2, R704.2, R706.2, R707.2, U701.5 (VSS), U701.16 (VSS), U701.29 (VSS), X701.2 (GND); also elsewhere on the board
Heartbeat_LED: U701.4 (RA5); also elsewhere on the board
I2C_CONFIG: R705.2, R706.1, U701.15 (RC7)
I2C_Error_LED: U701.7 (RA6/OSC2/CLKOUT); also elsewhere on the board
I2C_SCL: R701.2, U701.23 (RB5); also elsewhere on the board
I2C_SDA: R702.2, U701.22 (RB4); also elsewhere on the board
ICSPCLK: U701.24 (RB6/ICSPCLK); also elsewhere on the board
ICSPDAT: U701.25 (RB7/ICSPDAT); also elsewhere on the board
LED_EN: U701.28 (RA1); also elsewhere on the board
LED_PWM: U701.27 (RA0); also elsewhere on the board
unnamed: C701.1, C702.1, C703.1, L701.1, X701.1 (EN), X701.4 (Vdd)
unnamed: R703.2, X701.3 (OUT)
PIC18F_CLKR: R707.1, TP701.1, U701.10 (RC2)
PIC18F_SOSC: R703.1, R704.1, U701.9 (SOSCI/RC1)
POS5_PGOOD: U701.20 (RB2); also elsewhere on the board
POS5_USB_PGOOD: U701.21 (RB3); also elsewhere on the board
POS12_PGOOD: U701.8 (SOSCO/RC0); also elsewhere on the board
Reset_LED: U701.3 (RA4); also elsewhere on the board
USB_UART_RX: U701.11 (RC3); also elsewhere on the board
USB_UART_TX: U701.12 (RC4); also elsewhere on the board
UV_Error_LED: U701.6 (RA7/OSC1/CLKIN); also elsewhere on the board
~LED_FAULT: U701.1 (RA2); also elsewhere on the board
~MCLR: U701.26 (RE3/~MCLR~/Vpp); also elsewhere on the board

Notes on the sheet:
Place when I2C devices are present

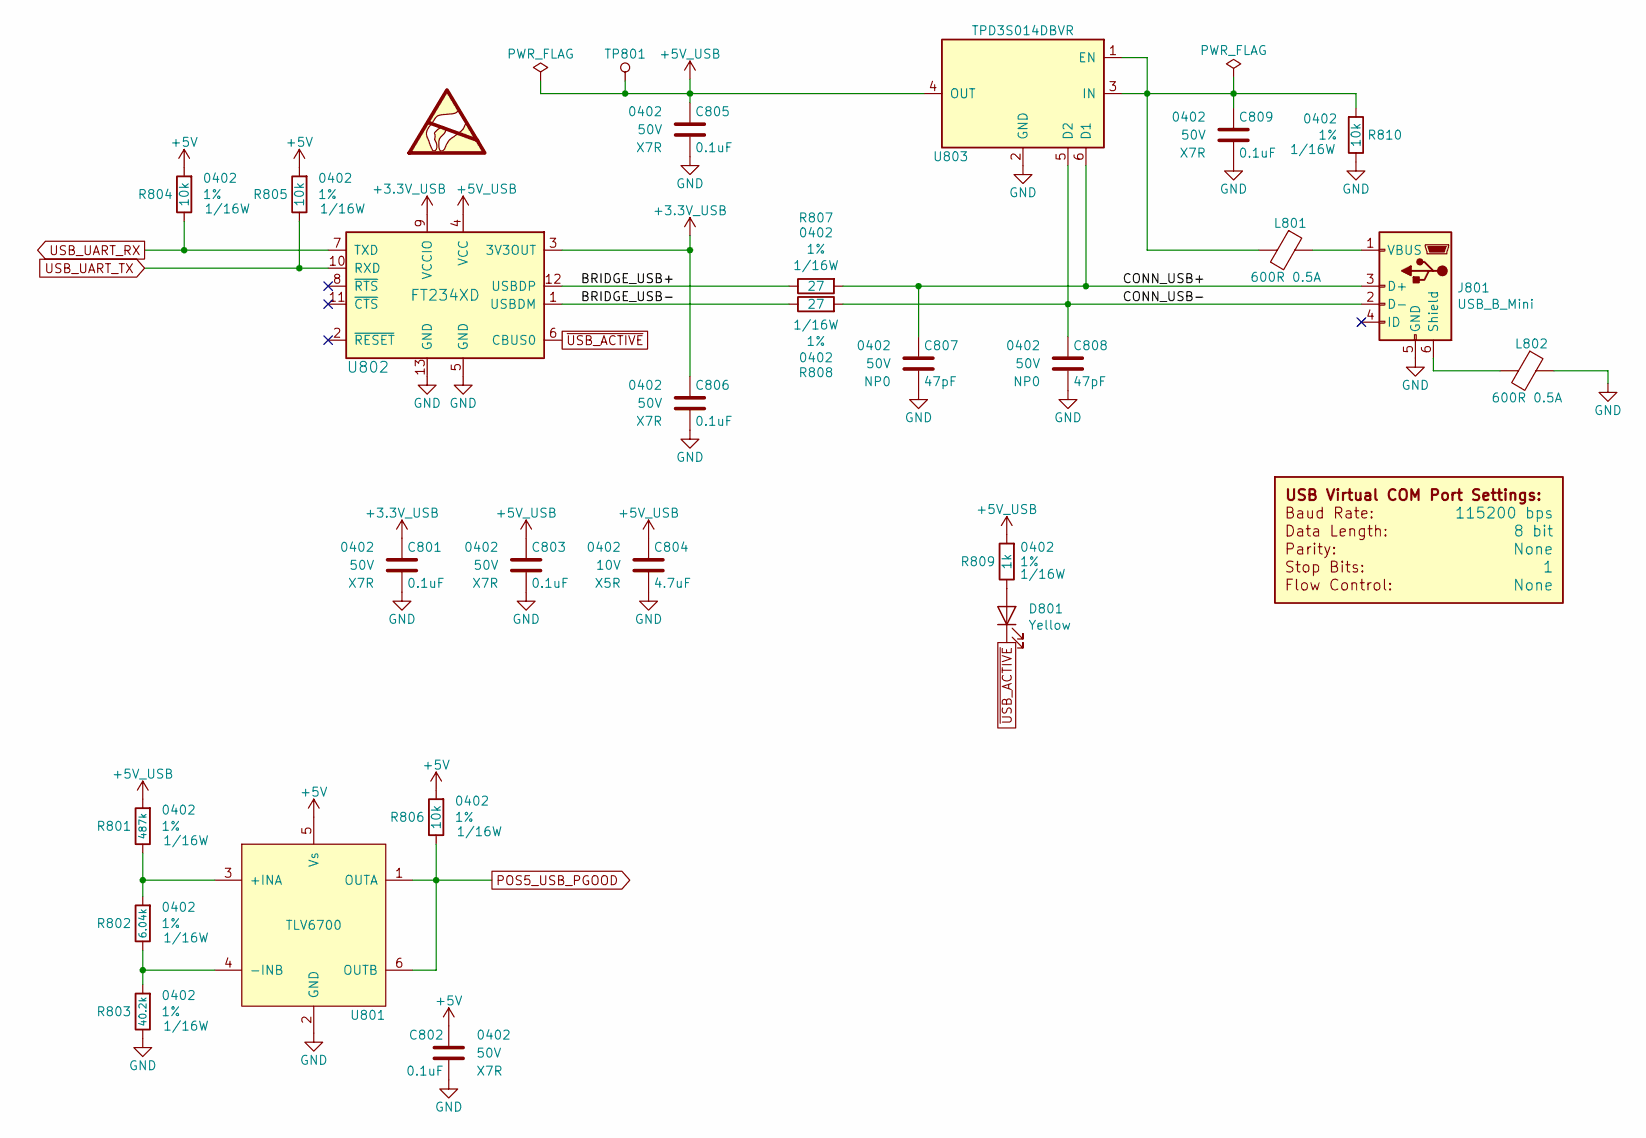
[picture p21: schematic USB_UART_Bridge.sch, UV Blaster]

Parts:
C801, C802, C803, C805, C806, C809: 0.1uF; C_0402; Voltage 50V; Digi-Key PN 490-10701-1-ND
C804: 4.7uF; C_0402; Voltage 10V; Digi-Key PN 490-14306-1-ND
C807, C808: 47pF; C_0402; Voltage 50V; Digi-Key PN 399-7796-1-ND
D801: Yellow; LED_0402; Digi-Key PN 754-1809-1-ND
DOC801: COM_Port_Settings
J801: USB_B_Mini; USB_Mini-B; Digi-Key PN 732-2109-1-ND
L801, L802: 600R 0.5A; L_0402; Digi-Key PN 490-16584-1-ND
R801: 487k; R_0402; Tolerance 1%; Digi-Key PN YAG2372CT-ND
R802: 6.04k; R_0402; Tolerance 1%; Digi-Key PN RMCF0402FT6K04CT-ND
R803: 40.2k; R_0402; Tolerance 1%; Digi-Key PN P40.2KLCT-ND
R804, R805, R806, R810: 10k; R_0402; Tolerance 1%; Digi-Key PN 541-3959-1-ND
R807, R808: 27; R_0402; Tolerance 1%; Digi-Key PN P27.0LCT-ND
R809: 1k; R_0402; Tolerance 1%; Digi-Key PN P1.00KLCT-ND
TP801: TP; Test_Point
U801: TLV6700; SOT-23-6; Digi-Key PN 296-51696-1-ND
U802: FT234XD; DFN-12-1EP_3x3mm_Pitch0.45mm; Digi-Key PN 768-1178-1-ND
U803: TPD3S014DBVR; SOT-23-6; Digi-Key PN 296-38835-1-ND

Connections:
+3.3V_USB: C801.1, C806.1, U802.3 (3V3OUT), U802.9 (VCCIO)
+5V: C802.1, R804.1, R805.1, R806.1, U801.5 (Vs); also elsewhere on the board
+5V_USB: C803.1, C804.1, C805.1, R801.1, R809.1, TP801.1, U802.4 (VCC), U803.4 (OUT)
/USB UART Bridge/BRIDGE_USB+: R807.2, U802.12 (USBDP)
/USB UART Bridge/BRIDGE_USB-: R808.2, U802.1 (USBDM)
/USB UART Bridge/CONN_USB+: C807.1, J801.3 (D+), R807.1, U803.6 (D1)
/USB UART Bridge/CONN_USB-: C808.1, J801.2 (D-), R808.1, U803.5 (D2)
GND: C801.2, C802.2, C803.2, C804.2, C805.2, C806.2, C807.2, C808.2, C809.2, J801.5 (GND), L802.1, R803.2, R810.2, U801.2 (GND), U802.5 (GND), U802.13 (GND), U803.2 (GND); also elsewhere on the board
unnamed: C809.1, L801.2, R810.1, U803.1 (EN), U803.3 (IN)
unnamed: D801.2 (A), R809.2
unnamed: J801.1 (VBUS), L801.1
unnamed: J801.6 (Shield), L802.2
unnamed: R801.2, R802.1, U801.3 (+INA)
unnamed: R802.2, R803.1, U801.4 (-INB)
POS5_USB_PGOOD: R806.2, U801.1 (OUTA), U801.6 (OUTB); also elsewhere on the board
USB_UART_RX: R804.2, U802.7 (TXD); also elsewhere on the board
USB_UART_TX: R805.2, U802.10 (RXD); also elsewhere on the board
~USB_ACTIVE: D801.1 (K), U802.6 (CBUS0)

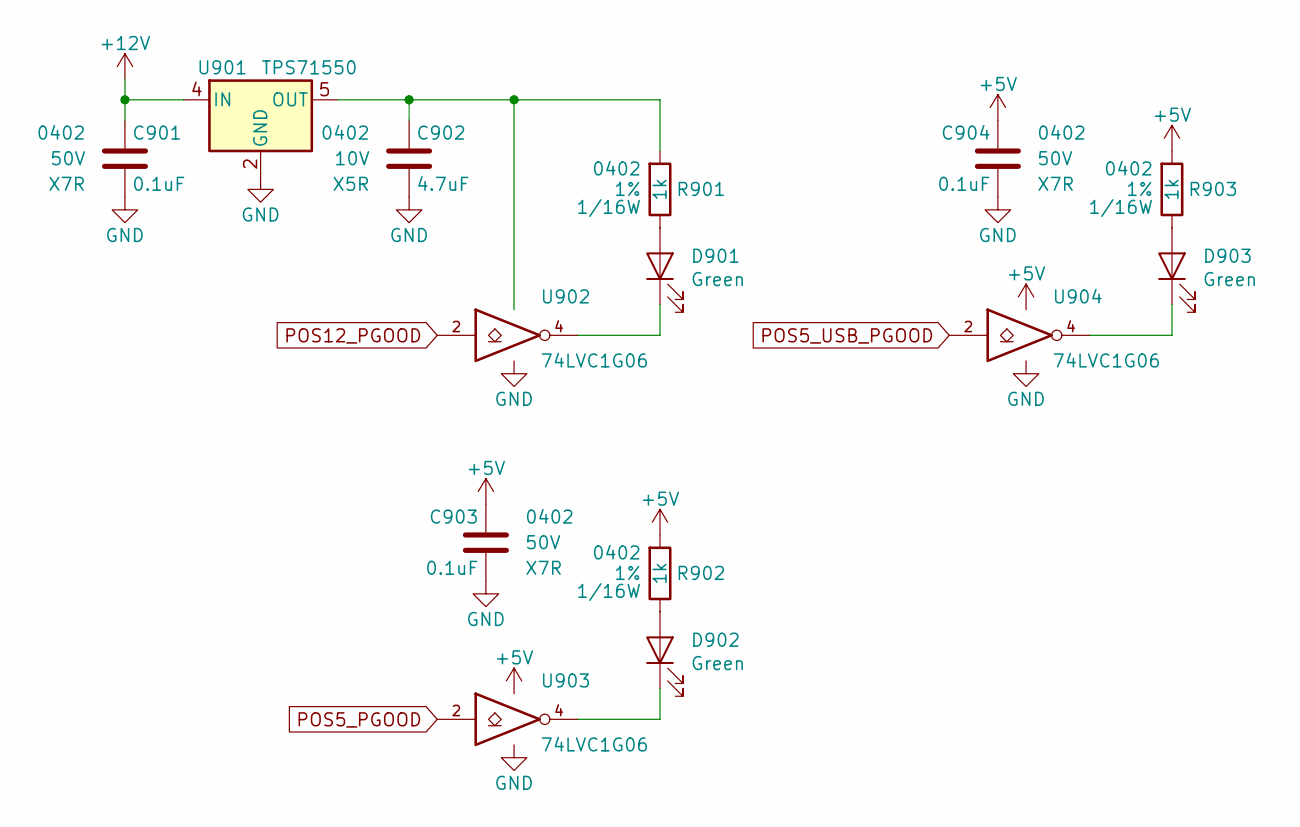
[picture p22: schematic PGOOD_LEDs.sch, UV Blaster]

Parts:
C901, C903, C904: 0.1uF; C_0402; Voltage 50V; Digi-Key PN 490-10701-1-ND
C902: 4.7uF; C_0402; Voltage 10V; Digi-Key PN 490-14306-1-ND
D901, D902, D903: Green; LED_0402; Digi-Key PN 754-1815-1-ND
R901, R902, R903: 1k; R_0402; Tolerance 1%; Digi-Key PN P1.00KLCT-ND
U901: TPS71550; SOT-353_SC-70-5; Digi-Key PN 296-15046-1-ND
U902, U903, U904: 74LVC1G06; SOT-353_SC-70-5; Digi-Key PN 296-8484-1-ND

Connections:
+5V: C903.1, C904.1, R902.1, R903.1, U903.5 (VCC), U904.5 (VCC); also elsewhere on the board
+12V: C901.1, U901.4 (IN); also elsewhere on the board
GND: C901.2, C902.2, C903.2, C904.2, U901.2 (GND), U902.3 (GND), U903.3 (GND), U904.3 (GND); also elsewhere on the board
unnamed: C902.1, R901.1, U901.5 (OUT), U902.5 (VCC)
unnamed: D901.1 (K), U902.4
unnamed: D901.2 (A), R901.2
unnamed: D902.1 (K), U903.4
unnamed: D902.2 (A), R902.2
unnamed: D903.1 (K), U904.4
unnamed: D903.2 (A), R903.2
POS5_PGOOD: U903.2; also elsewhere on the board
POS5_USB_PGOOD: U904.2; also elsewhere on the board
POS12_PGOOD: U902.2; also elsewhere on the board

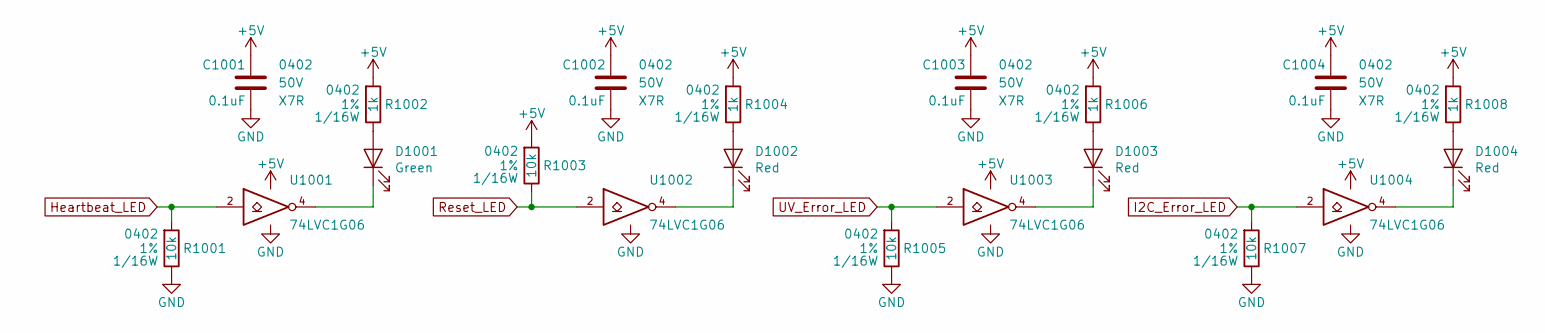
[picture p23: schematic Status_LEDs.sch, UV Blaster]

Parts:
C1001, C1002, C1003, C1004: 0.1uF; C_0402; Voltage 50V; Digi-Key PN 490-10701-1-ND
D1001: Green; LED_0402; Digi-Key PN 754-1815-1-ND
D1002, D1003, D1004: Red; LED_0402; Digi-Key PN 754-1812-1-ND
R1001, R1003, R1005, R1007: 10k; R_0402; Tolerance 1%; Digi-Key PN 541-3959-1-ND
R1002, R1004, R1006, R1008: 1k; R_0402; Tolerance 1%; Digi-Key PN P1.00KLCT-ND
U1001, U1002, U1003, U1004: 74LVC1G06; SOT-353_SC-70-5; Digi-Key PN 296-8484-1-ND

Connections:
+5V: C1001.1, C1002.1, C1003.1, C1004.1, R1002.1, R1003.1, R1004.1, R1006.1, R1008.1, U1001.5 (VCC), U1003.5 (VCC), U1004.5 (VCC); also elsewhere on the board
GND: C1001.2, C1002.2, C1003.2, C1004.2, R1001.2, R1005.2, R1007.2, U1001.3 (GND), U1002.3 (GND), U1003.3 (GND), U1004.3 (GND); also elsewhere on the board
Heartbeat_LED: R1001.1, U1001.2; also elsewhere on the board
I2C_Error_LED: R1007.1, U1004.2; also elsewhere on the board
unnamed: D1001.1 (K), U1001.4
unnamed: D1001.2 (A), R1002.2
unnamed: D1002.1 (K), U1002.4
unnamed: D1002.2 (A), R1004.2
unnamed: D1003.1 (K), U1003.4
unnamed: D1003.2 (A), R1006.2
unnamed: D1004.1 (K), U1004.4
unnamed: D1004.2 (A), R1008.2
Reset_LED: R1003.2, U1002.2; also elsewhere on the board
UV_Error_LED: R1005.1, U1003.2; also elsewhere on the board

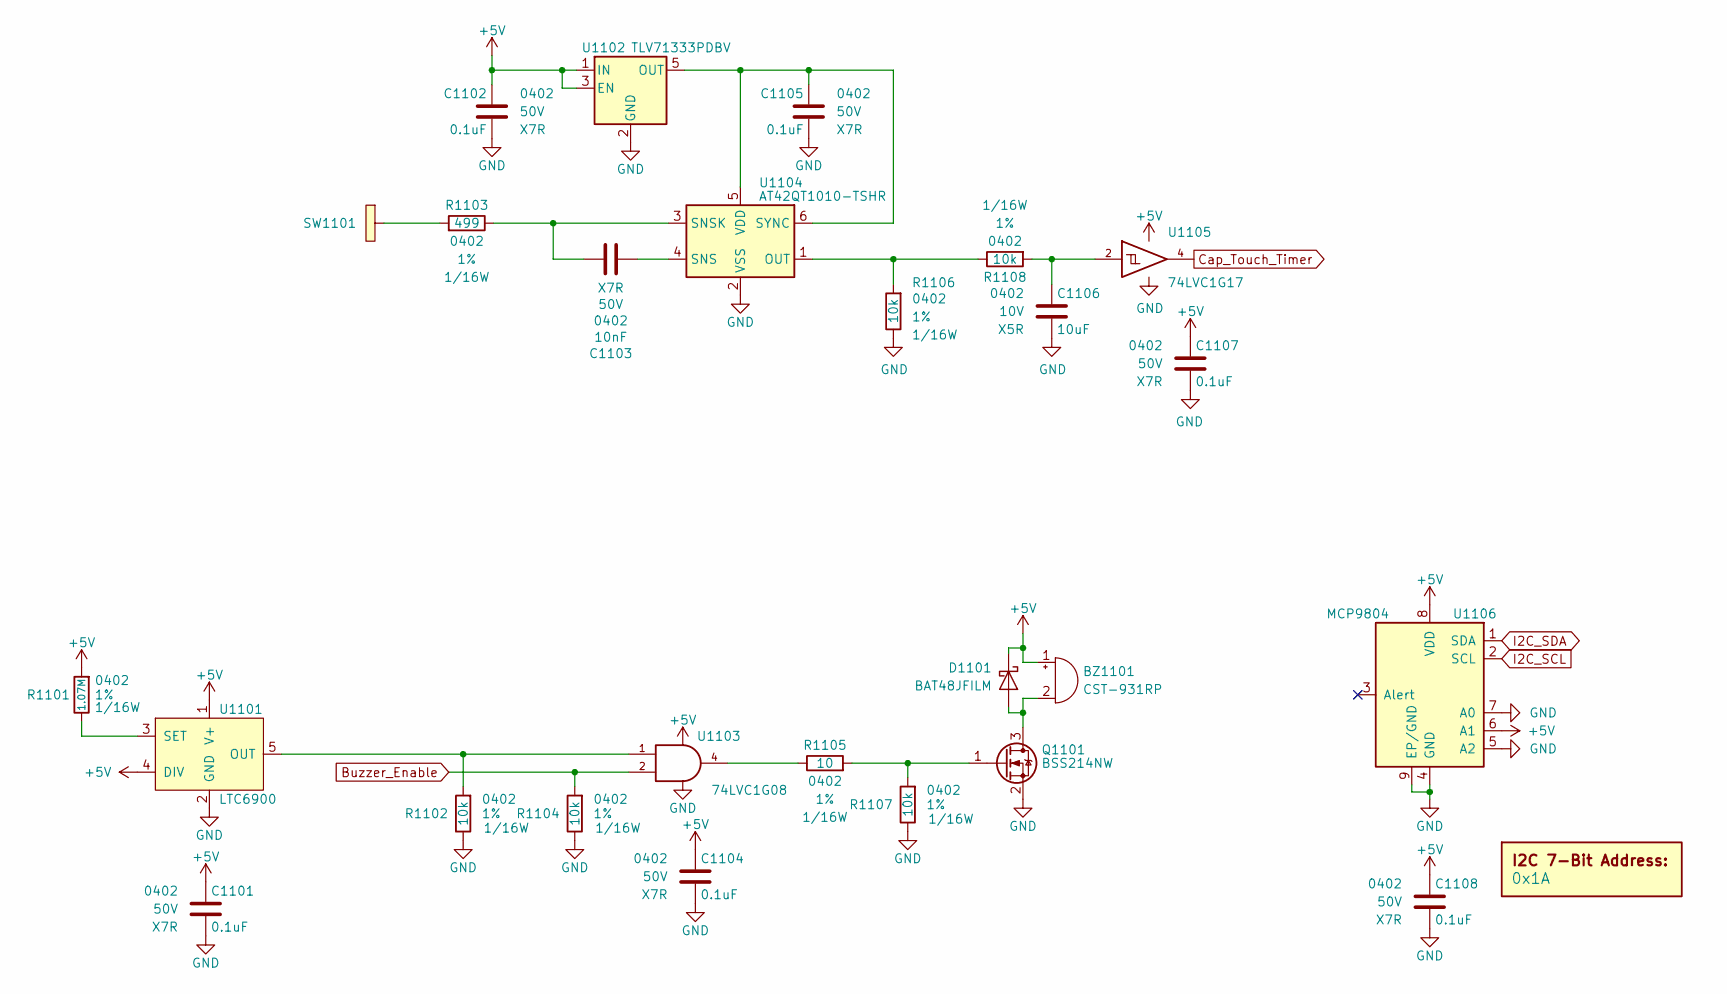
[picture p24: schematic Misc_IO.sch, UV Blaster]

Parts:
BZ1101: CST-931RP; MagneticBuzzer_CUI_CST-931RP-A; Digi-Key PN 102-1461-ND
C1101, C1102, C1104, C1105, C1107, C1108: 0.1uF; C_0402; Voltage 50V; Digi-Key PN 490-10701-1-ND
C1103: 10nF; C_0402; Voltage 50V; Digi-Key PN 490-13295-1-ND
C1106: 10uF; C_0402; Voltage 10V; Digi-Key PN 1276-6830-1-ND
D1101: BAT48JFILM; D_SOD-323; Digi-Key PN 497-5711-1-ND
DOC1101: 0x1A
Q1101: BSS214NW; SOT-323_SC-70; Digi-Key PN BSS214NWH6327XTSA1CT-ND
R1101: 1.07M; R_0402; Tolerance 1%; Digi-Key PN RMCF0402FT1M07CT-ND
R1102, R1104, R1106, R1107, R1108: 10k; R_0402; Tolerance 1%; Digi-Key PN 541-3959-1-ND
R1103: 499; R_0402; Tolerance 1%; Digi-Key PN P499LCT-ND
R1105: 10; R_0402; Tolerance 1%; Digi-Key PN 311-10.0LRCT-ND
SW1101: Cap_Touch; Capacitive_Touch_Pad
U1101: LTC6900; SOT-23-5; Digi-Key PN LTC6900CS5#TRMPBFCT-ND
U1102: TLV71333PDBV; SOT-23-5; Digi-Key PN 296-35591-1-ND
U1103: 74LVC1G08; SOT-353_SC-70-5; Digi-Key PN 296-11602-1-ND
U1104: AT42QT1010-TSHR; SOT-23-6; Digi-Key PN AT42QT1010-TSHRCT-ND
U1105: 74LVC1G17; SOT-353_SC-70-5; Digi-Key PN 296-11934-1-ND
U1106: MCP9804; DFN-8-1EP_3x2mm_P0.5mm_EP1.3x1.5mm; Digi-Key PN MCP9804T-E/MCCT-ND

Connections:
+5V: BZ1101.1 (-), C1101.1, C1102.1, C1104.1, C1107.1, C1108.1, D1101.1 (K), R1101.1, U1101.1 (V+), U1101.4 (DIV), U1102.1 (IN), U1102.3 (EN), U1103.5 (VCC), U1105.5 (VCC), U1106.6 (A1), U1106.8 (VDD); also elsewhere on the board
Buzzer_Enable: R1104.1, U1103.2; also elsewhere on the board
Cap_Touch_Timer: U1105.4; also elsewhere on the board
GND: C1101.2, C1102.2, C1104.2, C1105.2, C1106.2, C1107.2, C1108.2, Q1101.2 (S), R1102.2, R1104.2, R1106.2, R1107.2, U1101.2 (GND), U1102.2 (GND), U1103.3 (GND), U1104.2 (VSS), U1105.3 (GND), U1106.4 (GND), U1106.5 (A2), U1106.7 (A0), U1106.9 (EP/GND); also elsewhere on the board
I2C_SCL: U1106.2 (SCL); also elsewhere on the board
I2C_SDA: U1106.1 (SDA); also elsewhere on the board
unnamed: BZ1101.2 (+), D1101.2 (A), Q1101.3 (D)
unnamed: C1103.1, U1104.4 (SNS)
unnamed: C1103.2, R1103.2, U1104.3 (SNSK)
unnamed: C1105.1, U1102.5 (OUT), U1104.5 (VDD), U1104.6 (SYNC)
unnamed: C1106.1, R1108.1, U1105.2
unnamed: Q1101.1 (G), R1105.1, R1107.1
unnamed: R1101.2, U1101.3 (SET)
unnamed: R1102.1, U1101.5 (OUT), U1103.1
unnamed: R1103.1, SW1101.1
unnamed: R1105.2, U1103.4
unnamed: R1106.1, R1108.2, U1104.1 (OUT)
