drewsum/UV_Blaster/(commit log)

2020-05-03 Started schematic
    [LED_Driver.sch, LED_Driver_Telemetry.sch, Misc_IO.sch, PGOOD_LEDs.sch, PIC18F.sch, PIC18F_Programming.sch, POS12_Input.sch, POS12_Telemetry.sch]
2020-05-08 More sch work, netlist, part numbers, footprints
    [LED_Driver.sch, LED_Driver_Telemetry.sch, Misc_IO.sch, PGOOD_LEDs.sch, PIC18F.sch, PIC18F_Programming.sch, POS12_Input.sch, POS12_Telemetry.sch]
2020-05-08 Pulled in netlist into PCB
    [UV_Blaster.kicad_pcb]
2020-05-08 Arranged input power parts
    [UV_Blaster.kicad_pcb]
